AndreyPlis/balcon/render_eve_door.png

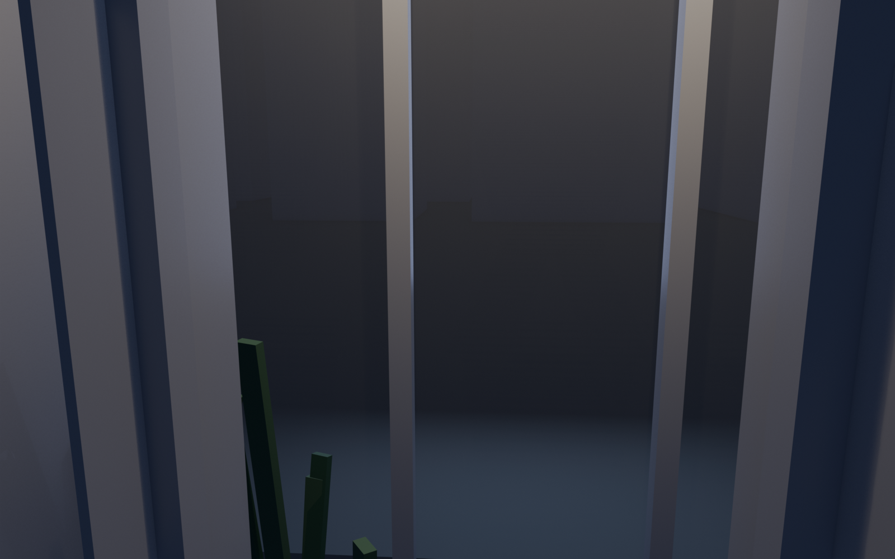
render_eve_door.png
