AndreyPlis/balcon/render_eve_corner.png

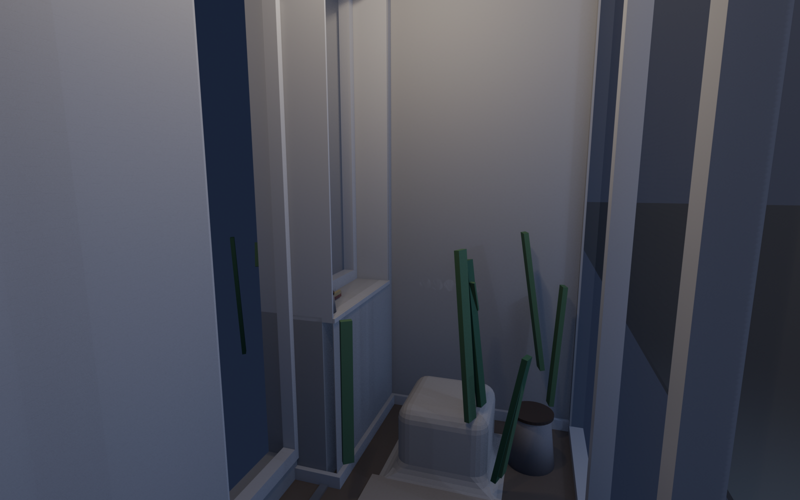
render_eve_corner.png
