AndreyPlis/balcon/guide.md

# Утепление лоджии PIR-панелями

Гайд собран из трёх роликов. Общий каркас — монтаж PIR. Финиш расходится: Технониколь ведёт штукатурку по стеклохолсту, омский мастер клеит ГКЛ на фольгу и присоединяет лоджию к комнате.

Источники:

- [ТН](https://www.youtube.com/watch?v=9BPyGYhEAY8) — заводская схема под штукатурку, 3:59
- [PIR](https://www.youtube.com/watch?v=_zJsMWyXZt4) — утепление присоединяемой лоджии, 10:50
- [ГКЛ](https://www.youtube.com/watch?v=zC0hL7GAGbw) — обшивка гипсокартоном поверх того же утепления, 14:20

## Какую схему брать

**Лоджия остаётся отдельной комнатой, финиш — штукатурка, плитка или камень.** Плиты со стеклохолстом. Холст клеится к стене и держит штукатурку, плиты заранее не грунтуют. [0:54](https://www.youtube.com/watch?v=9BPyGYhEAY8&t=54)

**Лоджию присоединяют к комнате, финиш — ГКЛ и декоративный кирпич.** Фольгированный PIR, листы на клей-пене, отверстия в утеплителе не сверлят. [0:00](https://www.youtube.com/watch?v=zC0hL7GAGbw&t=0)

Отдельная лоджия прощает ошибки: в мороз её можно закрыть. При присоединении контур должен быть герметичным целиком. [0:22](https://www.youtube.com/watch?v=_zJsMWyXZt4&t=22)

## Порядок работ

**1. Окна до утепления.** Рамы застройщика меняют целиком: профиль плохо держит тепло и вес тройного пакета. В заказ закладывают зазор под плиты. Окна не до пола — снизу запас под утеплитель не нужен. Пенят в самое тёплое окно по прогнозу. [0:48](https://www.youtube.com/watch?v=_zJsMWyXZt4&t=48) [1:12](https://www.youtube.com/watch?v=_zJsMWyXZt4&t=72) [1:38](https://www.youtube.com/watch?v=_zJsMWyXZt4&t=98)

**2. Толщина от отметки пола.** Перекрытие лоджии ниже пола квартиры примерно на 8 см и неровно. 50 мм PIR плюс стяжка в верхних точках не помещаются. Варианты: 50 мм и ступенька около 20 мм, либо 30 мм и пол в одну плоскость с комнатой. 30 мм тепло держат, тёплым пол становится только от тёплого пола. [2:16](https://www.youtube.com/watch?v=_zJsMWyXZt4&t=136) [4:24](https://www.youtube.com/watch?v=_zJsMWyXZt4&t=264) [4:41](https://www.youtube.com/watch?v=_zJsMWyXZt4&t=281)

Ориентир по эквиваленту: 50 мм PIR примерно как 65 мм ЭППС. На стены в маленькой лоджии берут 50 мм. Над плитами потолка оставляют место под профиль натяжного потолка. [1:51](https://www.youtube.com/watch?v=_zJsMWyXZt4&t=111) [2:04](https://www.youtube.com/watch?v=_zJsMWyXZt4&t=124) [3:43](https://www.youtube.com/watch?v=_zJsMWyXZt4&t=223)

**3. Демонтаж.** Сначала закрывают продуваемые щели. На время запенивания окно на проветривании, вытяжку квартиры закрывают, иначе пену выдувает. Перемычку разбирают по кускам. Если за облицовкой минвата вентфасада — респиратор и закрытая кожа. [5:42](https://www.youtube.com/watch?v=_zJsMWyXZt4&t=342) [5:58](https://www.youtube.com/watch?v=_zJsMWyXZt4&t=358) [6:17](https://www.youtube.com/watch?v=_zJsMWyXZt4&t=377) [1:24](https://www.youtube.com/watch?v=_zJsMWyXZt4&t=84)

**4. Основание.** Перепад стен и пола не больше 1 см на 2 м, иначе штукатурка. Наплывы бетона сбивают перфоратором, остальное снимают диском по бетону. [0:21](https://www.youtube.com/watch?v=9BPyGYhEAY8&t=21) [2:40](https://www.youtube.com/watch?v=_zJsMWyXZt4&t=160)

**5. Плиты: потолок, стены, пол.** Ряды от окна, вразбежку, обрезок переносят на следующий ряд. Зазоры минимальные: плита влаги не боится, пена боится, щель становится мостиком холода. [1:07](https://www.youtube.com/watch?v=9BPyGYhEAY8&t=67) [8:02](https://www.youtube.com/watch?v=_zJsMWyXZt4&t=482) [8:28](https://www.youtube.com/watch?v=_zJsMWyXZt4&t=508)

Клей-пена LOGICPIR. Полоса разомкнутая, без замкнутого контура, иначе плиту раздует. Стыки пропенивают той же пеной. [1:28](https://www.youtube.com/watch?v=9BPyGYhEAY8&t=88)

Через 24 часа — фасадные дюбели, не меньше двух на плиту. На потолок дюбели ставят в любом случае. На фольгу завод пену единственным креплением не разрешает; на стенах пена у мастера оторвала скорее плиту, чем шов. [1:55](https://www.youtube.com/watch?v=9BPyGYhEAY8&t=115) [6:55](https://www.youtube.com/watch?v=_zJsMWyXZt4&t=415) [7:50](https://www.youtube.com/watch?v=_zJsMWyXZt4&t=470)

**6. Герметичный контур.** Каждый стык и каждая шляпка дюбеля — алюминиевый скотч, не самый тонкий. На полу скотч замыкает пароизоляцию. [3:10](https://www.youtube.com/watch?v=9BPyGYhEAY8&t=190) [9:43](https://www.youtube.com/watch?v=_zJsMWyXZt4&t=583)

**7. Пол.** Напольный LOGICPIR с алюмоламинатом идёт под сухую и мокрую стяжку: покрытие защищает фольгу от щёлочи. Стеновую плиту на пол кладут только если напольной нужной толщины нет, и тогда под стяжку стелят плёнку. В ролике напольная была только 50 мм, стеновая — 30 мм, на пол ушли стеновые. [3:10](https://www.youtube.com/watch?v=9BPyGYhEAY8&t=190) [3:15](https://www.youtube.com/watch?v=_zJsMWyXZt4&t=195) [8:41](https://www.youtube.com/watch?v=_zJsMWyXZt4&t=521)

Стяжка около 40 мм. Кладочная сетка в середине слоя. Наливной пол вместо грубого ровнителя, плюс фибра. Заливка в два приёма: первый слой с фиброй, через час второй без неё. Заводской вариант пола — полусухая стяжка. Через две недели работы трещин не было. [8:54](https://www.youtube.com/watch?v=_zJsMWyXZt4&t=534) [3:27](https://www.youtube.com/watch?v=9BPyGYhEAY8&t=207) [9:32](https://www.youtube.com/watch?v=_zJsMWyXZt4&t=572)

**8а. Финиш штукатуркой.** Базовый слой, в него щелочестойкая фасадная сетка, затирка. Финиш после высыхания, не раньше 72 часов: шпаклёвка, шлифовка, грунт, затем декоративная штукатурка, плитка или камень. [2:14](https://www.youtube.com/watch?v=9BPyGYhEAY8&t=134) [2:35](https://www.youtube.com/watch?v=9BPyGYhEAY8&t=155)

**8б. Финиш ГКЛ.** Влагостойкий лист 12 мм, можно в два слоя. Направляющий 27×28 клеят пеной к полу; в стяжку его сажают газовым пистолетом — это единственное жёсткое основание. Пока пена встаёт, на PIR клеят пятаки из ГКЛ или фанеры и в них вкручивают подвесы-упоры. Сквозь утеплитель не сверлят. Профили оставляют там, где за листом розетки и провода. Остальные листы клеят клей-пеной к полу и к плитам. [0:27](https://www.youtube.com/watch?v=zC0hL7GAGbw&t=27) [1:10](https://www.youtube.com/watch?v=zC0hL7GAGbw&t=70) [2:41](https://www.youtube.com/watch?v=zC0hL7GAGbw&t=161) [12:19](https://www.youtube.com/watch?v=zC0hL7GAGbw&t=739)

Откосы грунтуют и сажают на Perlfix либо на цементную штукатурку по всей площади, с контактным слоем на стене и на листе, в уровень и под 90°. Высохший откос — ребро, в которое упирается стена. Под декоративный кирпич откос из ГКЛ подходит. Под обои откос делают пластиковым: окно плачет, обои отходят. [4:26](https://www.youtube.com/watch?v=zC0hL7GAGbw&t=266) [6:12](https://www.youtube.com/watch?v=zC0hL7GAGbw&t=372) [7:17](https://www.youtube.com/watch?v=zC0hL7GAGbw&t=437)

Где профилю нет места, лист фрезеруют и клеят целиком на клей-пену. В пене у рамы — паз 12 мм на глубину около 1 см. Металл запенивают умеренно. Подоконник потом добавляет точку крепления. Под кирпич сплошь не шпаклюют: перфоуголок на стыке с обоями, Волма Шов. [9:59](https://www.youtube.com/watch?v=zC0hL7GAGbw&t=599) [10:12](https://www.youtube.com/watch?v=zC0hL7GAGbw&t=612) [11:51](https://www.youtube.com/watch?v=zC0hL7GAGbw&t=711) [12:46](https://www.youtube.com/watch?v=zC0hL7GAGbw&t=766)

## Лайфхаки

| Приём | Зачем | Где |
|---|---|---|
| Пена разомкнутым контуром | Замкнутая полоса запирает воздух, плиту выгибает | [1:28](https://www.youtube.com/watch?v=9BPyGYhEAY8&t=88) |
| Монтаж от окна | Самый холодный стык получается самым плотным | [8:28](https://www.youtube.com/watch?v=_zJsMWyXZt4&t=508) |
| Скотч на шляпки дюбелей | Отверстие крепежа — такая же дыра, как стык | [9:43](https://www.youtube.com/watch?v=_zJsMWyXZt4&t=583) |
| Толстый алюминиевый скотч | Тонкий рвётся на фольге и на шляпках | [9:43](https://www.youtube.com/watch?v=_zJsMWyXZt4&t=583) |
| Два пистолета | Клей-пену не увлажняют, монтажную увлажняют; смешивать их в одном пистолете нельзя | [10:48](https://www.youtube.com/watch?v=zC0hL7GAGbw&t=648) |
| Tytan 60 секунд | Остальные клей-пены схватываются сильно дольше, лист успевает сползти | [12:34](https://www.youtube.com/watch?v=zC0hL7GAGbw&t=754) |
| Пятак из ГКЛ под подвес | Упор на время пены без дыры в PIR | [1:10](https://www.youtube.com/watch?v=zC0hL7GAGbw&t=70) |
| Палец на фольге под лазер | Зелёный луч на фольге не виден | [3:18](https://www.youtube.com/watch?v=zC0hL7GAGbw&t=198) |
| Глубина фрезы по лезвию ножа | Лезвие между двумя обрезками равно толщине картона, картон остаётся | [8:39](https://www.youtube.com/watch?v=zC0hL7GAGbw&t=519) |
| Отступ 55 мм от края площадки фрезера | Иначе паз уезжает от линии сгиба; свой фрезер надо перемерить | [8:00](https://www.youtube.com/watch?v=zC0hL7GAGbw&t=480) |
| Профиль пилят, а не режут ножницами | Ножницы заминают полки, профиль потом не встаёт | [3:58](https://www.youtube.com/watch?v=zC0hL7GAGbw&t=238) |
| Провода держит пена | Алюминиевый скотч нагрузку не несёт | [6:54](https://www.youtube.com/watch?v=zC0hL7GAGbw&t=414) |
| Сетку поднимают в тело стяжки | Сетка на PIR не армирует слой | [8:54](https://www.youtube.com/watch?v=_zJsMWyXZt4&t=534) |
| Болгарка по бетону греется | Наплывы сначала перфоратором, диск только на остаток | [2:40](https://www.youtube.com/watch?v=_zJsMWyXZt4&t=160) |
| Смету углов считают по штукам | Площади мало, углов много, цена за м² обманывает | [13:13](https://www.youtube.com/watch?v=zC0hL7GAGbw&t=793) |

Паузы, которые нельзя сжимать: сутки до дюбелей, трое суток до декоративной штукатурки, около часа между слоями наливного пола.
