AndreyPlis/balcon/docs/superpowers/specs/2026-10-06-loggia-blender-design.md

# Loggia → Blender: визуализация чистового интерьера

Дата: 2026-10-06. Источник геометрии: `Loggia.FCStd` (открыт и проверен через FreeCAD MCP), размеры — `loggia_params.md`, отделка — `пол.md` / `потолок.md` / `стены.md`.

## Цель

Сцена `.blend` с чистовым интерьером лоджии после ремонта + рендеры EEVEE (день и вечер, 2 ракурса). Скрытые конструктивные слои (PIR, рейки, гофра, подвесы) не показываются.

## Подход

Экспорт видимой отделочной геометрии из FreeCAD в OBJ → импорт в Blender (мм → м, масштаб 0.001) → материалы, декор, свет, камеры. Основание: вся отделка уже смоделирована в FCStd 1:1 — импорт исключает ошибки ручной перестройки.

## Состав сцены

Из FCStd (видимые слои):
- Коробка: задняя стена с проёмами, боковые стены, плиты пола/потолка, панорамное остекление (рама 70 мм, стеклопакет, доборы 120/110).
- Входной блок: окно (стекло), дверь (полотно), откосы Venta, ступень с SPC, порожек Лука 37 мм.
- Отделка: пол SPC «Дуб Берн» (Z 129–133), стены и задняя стена — панели «Кирпич серый», потолок — 27 ламелей ПВХ по 100 мм + доборная (Z 2695–2705), GX53 — 2 светильника по макету (в смете 3; расхождение зафиксировано, следует макету), подоконник ПВХ 200 мм, плинтусы ПВХ, рамка Legrand Valena 5 постов (простенок справа от двери, Z≈900).

Материалы (процедурные, без внешних ассетов):
- Пол: тёплый коричневый дуб, доски с расшивкой (Wave+Noise).
- Стены: серый кирпич (Brick Texture, серые тона, шов светлее).
- Потолок/ПВХ/рама/откосы/подоконник/дверь: белый пластик (лёгкий шершавый глянец).
- Стекло: прозрачное (Glass BSDF / EEVEE-эквивалент с блендом), лёгкий зелёный оттенок кромки не нужен.

Декор (лёгкий, на полу/подоконнике, не по спецификации):
- Коврик у панорамы, пуф-подушка, сансевиерия в кашпо на полу (угол у панорамы), маленькое растение на подоконнике, 2–3 книги.

Свет и камеры:
- День: Sun с улицы через панораму + небо, Evening-вариант отключён.
- Вечер: тёмное окружение, GX53 — эмиссивные диски 4000K + небольшие Point-источники для засвета.
- Камеры: «из двери» (как точка замеров) и «из угла» на панораму/подоконник.
- Рендер: EEVEE, 4 картинки (2 ракурса × день/вечер).

## Результат

- `loggia_design.blend` в корне репо (экспорт OBJ рядом, `loggia_export/`).
- 4 PNG-рендера: `render_day_door.png`, `render_day_corner.png`, `render_eve_door.png`, `render_eve_corner.png`.

## Не входит

Мебельные модули/шкафы, вид с улицы, разнесённый вид пирога, анимация, Cycles.
