AndreyPlis/balcon/loggia_params.md

# Параметрика модели «Loggia» — все размеры в мм

СК: origin = левый задний угол на уровне пола лоджии; X — слева направо, Y — от входа (задняя стенка) к панораме, Z — вверх.
Точка обзора замеров: человек стоит в двери, смотрит на панораму.

## 1. Помещение — внутренние габариты

| Параметр | Замер | В модели |
|---|---|---|
| Длина X (между боковыми стенами) | пол 2793/2789, потолок 2784/2788 | **2791** |
| Глубина Y (задняя стена → остекление) | лев. 1075 низ / 1065 верх, прав. 1081/1072 | **1077** |
| Высота Z | 2798–2811, среднее по 7 точкам | **2806** |
| Наклон стен (в модели — прямота, в допуск) | бока ~10, торцы ~5 | — |
| Объём / площадь пола | — | 8.43 м³ / 3.01 м² |

## 2. Задняя стенка — входной блок

| Элемент | Замер | В модели |
|---|---|---|
| Простенок слева (до окна) | 125 | X 0–125 |
| Окно ширина | 734 (1437.5 − 703) | X 125–859 |
| Окно высота / низ от пола | 1570 / 915–920 | Z 917–2488 (верх общий с дверью, `BlockTop`) |
| Дверь ширина | 703 | X 859–1562 |
| Дверь: порог / полотно | +230 / +280 (перемер), проём 2258 | Z 230–2488 |
| Простенок справа | 1209 / 1213 / 1215 (перемер) | **1229 расчёт** (+14 непараллельность боковых стен) |
| Над проёмом до потолка | 307 / 320 (перемер, потолок у двери 2807) | 318 |
| Откос двери правый | 140 | Y 0–140 за грань |
| Рамы блока (утоплены) | — | Y −140…−190 |

## 3. Панорамное остекление (фронт)

| Параметр | Замер | В модели |
|---|---|---|
| Низ рамы от пола | 180 | Z 180 |
| Верх рамы от потолка | 120 | Z 2686 |
| Высота стекла | 2506 (расчёт) | 180 + 2506 + 120 = 2806 ✓ |
| Боковые стены | длина 1065–1081 | заканчиваются на Y 1077 (`Dep`), внутрь зоны панорамы не заходят |
| Плоскость рамы панорамы | — | Y 1077 (`GlazY = Dep`), в плоскости торцов стен |
| Добор левый (до штапика) | 120 (перемер; ранее 125–140) | панель в плоскости остекления, ширина по X 120, толщина 10, на всю высоту |
| Добор правый | 110 (перемер; ранее 125) | ширина по X 110, толщина 10, на всю высоту |
| Рама панорамы | — | X 120–2681 (между доборами), профиль 70 условный, Y 1077–1147 |
| Стеклопакет (факт, установлен) | двухкамерный 4‑14‑4‑14‑4i, толщина 40, одно i‑стекло | U центра ~1.3, по окну ~1.4 Вт/м²·К; потери при −25 °C ≈ 440 Вт, общие потери лоджии ≈ 11 Вт/К |
| Площадь остекления | — | 2561 × 2506 = 6.42 м² |

## 4. Элементы внутри лоджии

| Элемент | Размеры | Позиция |
|---|---|---|
| Подоконник | 735 × 135 × 20 | в проёме окна, Y −135…0 (перемер глубины 135; до рамы на 140 остаётся 5), верх Z 917–920 |
| Ступень | 703 × 150 × 230 | в откосе двери, Y −150…0, заподлицо со стеной (перемер), полотно двери на +280 |

## 5. Конструктив и материалы

| Элемент | Материал | Примыкание / примечание | В модели |
|---|---|---|---|
| Левая боковая стена | Кирпич | К тёплому помещению | `WallLeft_Brick`, толщина 120 (!! заглушка) |
| Правая боковая стена | Кирпич | К тёплому помещению | `WallRight_Brick`, толщина 120 (!! заглушка) |
| Внутренняя (задняя) стена | Кирпич | Стена дома, тёплая | `WallBack`, толщина 300 (!! заглушка) |
| Пол | Ж/б плита | — | `SlabFloor`, 150 (!! заглушка) |
| Потолок | Ж/б плита | — | `SlabCeil`, 160 (!! заглушка) |
| Панорама, профиль | Melke Evolution 70 (ПВХ) | Монтажная глубина 70 = `FrameT` | `FrontParapet`, `FrontTopBand` |
| Панорама, стеклопакет | 4/14/4/14/4i | Двухкамерный 40 мм, одно i‑стекло | `Glazing` |
| Окно входного блока | 4/14/4/14/4i | То же заполнение | `BackWindowGlass` |
| Доборы панорамы | ПВХ | — | `RevealPan_Left/Right` |
| Подоконник, дверь, ступень | ПВХ / ПВХ / кирпич‑бетон | — | `Sill`, `BackDoorLeaf`, `Step` |

Материал записан на каждом теле в FreeCAD в строковых свойствах `Material` и `Note` (группа «Loggia»), а также в таблице `Params`, блок «МАТЕРИАЛЫ» (строки 36–44).
Толщины стен и плит не замерялись.

## 6. Утепление и отделка

В модели есть (восстановлено после чистки):

- **Утепление**: `InsLeft`/`InsRight` — PIR 50 (боковые); `InsBack_PierL`/`InsBack_PierR`/`InsBack_Top`/`InsBack_UnderWin` — PIR 30 (задняя); `InsCeil` — PIR 50; `InsFloor` + `InsFloor2` — пол, 2 слоя по 50. Материал и назначение каждого тела — в свойствах `Material`/`Note` (группа «Loggia»).
- **Потолок**: 3 профиля CD 60×27 (`CeilProf1..3`), 12 подвесов (`CeilHang01..12`), 8 панелей ПВХ Venta 375×3000×8 глянец белая (`CeilPanel01..08`, полосы 1077, последняя — подрезка 166), GX53 (`Lamp1/2_*`, `Lamp3_*`).
- **Стены**: каркас — **брусок строганый 30×40 (Лемана ПРО, хвоя Оптима) на пене к фольге, шаг 400, все стены** (`LatL_*`, `LatR_*`, `LatB_*`, включая вертикальные вставки над проёмом и под окном — продолжение сетки; полость 30 — под гофру D20; брусок с антисептиком-огнебиозащитой); `Material`/`Note` прописаны. Панели МДФ Stella «ледяное дерево» 2700×200×6 горизонтально (`FinB_*`, `FinL`, `FinR`), плинтус (`Base*`), подоконник 200 мм (`SillNew`), накладные механизмы, корпуса вертикально на рейках: тройной блок Legrand Quteo с/з — левая стена, на `LatL_2` (ось Y=600, Z≈780–1020, `SocketBox3`); выключатель (Z=900) + Grand Meyer MST-1 (Z=1000) — задняя стена справа от входа, на `LatB_R1` (ось X=1800, `SocketBox1/2`), без подрозетников и закладных. Пирог стен: левая/правая 86 мм, задняя 66 мм ([проект.md](проект.md)); в `Params` — `LatT` 30 / `LatW` 40 (61–62), `LatLT` 30 / `LatLW` 40 (72–73), `FinT` 6.
- **Пол**: PIR слой 2, ГВЛВ 20 (`FloorGVL`), подложка 3 (`FloorSub`), SPC Corsa Deco 5,3 (`FloorSPC`, `StepSPC`), ступень после среза (`Cut_StepUnder`, `WallBackStep`, `Threshold`, `BaseJamb*`).
- **Электрика**: ввод (`CableEntry*`), провода (`Wire*`), распаячная коробка (`JBox`), датчик пола (`WireSens*`).

Таблица `Params` содержит блоки «МАТЕРИАЛЫ» (36–44), «ВВОД КАБЕЛЯ» (45–48), «УТЕПЛЕНИЕ» (49–71: PirT 50 / PirWT 30, каркас потолка CD, ламели, каркас стен LatT/LatW, финиш 3 мм, пирог пола).

## Контрольные цепочки

- Вертикаль окна: 917 + 1571 + 318 = 2806 ✓
- Вертикаль двери: 230 + 2258 + 318 = 2806 ✓ (замер у двери 230 + 2258 + 320 = 2808 ≈ 2807)
- Панорама: 180 + 2506 + 120 = 2806 ✓
- Горизонталь задней стенки: 125 + 734 + 703 + 1229 = 2791 ✓ (замер на высоте 1 м: 125 + 1440 + 1215 = 2780, наклон стен)
- От левой стены до правого края окна: 125 + 734 = 859 ≈ 863 (замер) ✓
