AndreyPlis/balcon/план работ.md

# План работ — утепление и отделка лоджии

Сквозной порядок работ по проекту ([проект.md](проект.md)). Конструкции, смета и альтернативы — в разделах проекта.

## Раскладка по дням (1 человек; порядок «подготовка → утепление → черновая → финиш», паузы из [гайда](guide.md) не сжимать)

**День 0 — подготовительный: подготовка пола, грубый срез ступени, ввод электрики (все грязные работы)**
Подготовка пола и потолка: сбить наплывы >10 мм перфоратором (диск по бетону — только на остаток), пропылесосить → грубый срез ступени: борозда алмазным диском по периметру + отбойник (пика/лопатка), основная масса до ~117 мм → торец среза в комнату зачистить → завод электрики: бур 25×600, сквозное отверстие Ø25, ось **80 мм от левой стены, у верха окна (Z=2488)** — простенок, вне пирога левой стены (PIR 50 + полость 40 + панель 3) и с запасом под подрозетник Ø68 в комнате (Ø68 на оси 80 → 46–114 от угла), **ввод один 3×2,5 с PE в гофре D20 сквозь стену** (шлейф от розетки в комнате; гофра до распаячной коробки — кабель заменяем), фольгу вокруг ввода — скотч, зазор вокруг гофры временно — ветошью (пена — при отделке откосов).
*Материалы на день:*

| Материал | Кол-во | Цена, ₽ | Ссылка |
|---|---|---|---|
| Кабель ВВГ-Пнг(А) 3×2,5 ГОСТ (ввод — единственный кабель в отверстии) — **куплен** | ~10 м | 123/м | [electrolait.ru](https://electrolait.ru/shop/kabel/vvg/vvg-pnga-3h25-dmitrov-kabel-gost/) |
| Гофра ПВХ D20, самозатухающая (ввод сквозь стену + трасса до коробки; остаток бухты — трассы розеток и тёплого пола в Д4; при заказе уточнить зонд) — **куплена** | 12 м | 13/м | [electrolait.ru](https://electrolait.ru/shop/prokladka-kabelya/gofra/truba-pvh-gofrirovannaya-diametr-20mm/) |
| Изолента, малярный скотч (расходники) | — | — | — |

*Инструмент* (прочерк — уже есть в хозяйстве):

| Инструмент | Цена, ₽ | Ссылка |
|---|---|---|
| Перфоратор SDS-plus | — | — |
| Бур SDS-plus Rage 562560 25×600 мм (4,5/5, 105 отзывов; Ø25 = наружный Ø гофры D20 +25%; Ø20 гофре мало — не пройдёт; сверлить с перерывами, беречь напайку от арматуры) — **куплен** | — | [lemanapro.ru](https://lemanapro.ru/product/bur-po-betonu-sds-plus-rage-562560-25x600-mm-89369128/) |
| УШМ 125 мм | — | — |
| Диск алмазный по бетону Rage 600132 сегментный 125×2,2 — **куплен 07.10** | — | [lemanapro.ru](https://lemanapro.ru/product/disk-almaznyy-po-betonu-rage-600132-segmentnyy-125x222x22-mm-89435058/) |
| Пика по бетону SDS-plus 250 мм — **куплена** | — | [lemanapro.ru](https://lemanapro.ru/product/pika-po-betonu-sds-plus-250-mm-86407420/) |
| Зубило лопаточное SDS-plus 40×250 мм — **куплено** | — | [lemanapro.ru](https://lemanapro.ru/product/zubilo-lopatochnoe-sds-plus-40x250-mm-86508679/) |
| Чашка алмазная двухрядная по бетону Vira 592035 125×22,2 мм (19 отзывов; к УШМ — шлифовка плиты пола, ровный след без биения) — **куплена 13.10** | — | [lemanapro.ru](https://tver.lemanapro.ru/product/chashka-almaznaya-dvuhryadnaya-po-betonu-vira-592035-125x222-mm-89418165/) |
| Пылесос, очки, респиратор, перчатки | — | — |

**Итого покупок дня 0: 4 073 ₽** — всё куплено (материалы 1 386 + инструмент 2 687; диск Rage 876 ₽ — 07.10, чаша Vira 558 ₽ — 13.10).

**День 1 — утепление потолка и стен**
Распил: 3 CD по ~2618 (УШМ); брусок 30×40 — 12 шт до ~2806 (торцовка/ножовка; под антисептиком-огнебиозащитой с Д0) → PIR потолка на клей-пену (листы 1190×590 двумя продольными рядами 590+487 вдоль 2791, **вразбежку**: ряд 590 [1190+1190+411], ряд 487 [411+1190+1190] — вставка ряда из отрезка предыдущего листа, швы соседних рядов разнесены на ≥411; отрезки 103 мм — в доборы; ~5 листов, полосы разомкнутые, от угла панорамы) → PIR стен (**вразбежку**: боковые — колонки 590/487, колонка 590 [1190+1190+426] от панорамы, колонка 487 [426+1190+1190] — вставки из листов-доноров, ~9–10 листов; задняя 30-мм — колонки с тем же чередованием [1190+1190+426]/[426+1190+1190] с подрезкой проёмов; от угла панорамы, стыки пропенить). Пол (Д2/Д3) — та же раскладка **вразбежку в двух уровнях**: слой 1 — ряд 590 [1190+1190+411], ряд 487 [411+1190+1190]; слой 2 — зеркально (ряд 590 [411+1190+1190], ряд 487 [1190+1190+411]) — сдвиг швов и внутри слоя, и между слоями ≥411 ≥200. Итого 50-мм: ~22,5 чистых листа из 25 (5 уп) — запас ~2,5 листа.
*Материалы на день:*

| Материал | Кол-во | Цена, ₽ | Ссылка |
|---|---|---|---|
| PIR Logicpir Баня ф/ф Г1 L-кромка 1190×590×50, уп. 5 плит/3,51 м² — фирменный магазин ТН (Г1 — не «Балкон»/«Полы» с Г4; обе позиции заказа с L-кромкой; потолок + стены ≈ 3 уп, общий заказ 5 уп) | 3 уп | 4 329/уп | [tver.tstn.ru](https://tver.tstn.ru/product/logicpir-banya-f-f-g2-l-1190kh590kh50/) |
| PIR Logicpir Баня ф/ф Г1 L-кромка 1190×590×30, уп. 8 плит/5,62 м² — фирменный магазин ТН (единый формат с 50-мм) | 1 уп | 4 918/уп | [tver.tstn.ru](https://tver.tstn.ru/product/logicpir-banya-f-f-g2-l-1190kh590kh30/) |
| Клей-пена Logicpir 1000 мл (потолок + стены) — фирменный магазин ТН (−484 ₽/баллон к Лемане) | 4 шт | 1 414 | [tver.tstn.ru](https://tver.tstn.ru/product/kley-pena-tekhnonikol-logicpir-1000-ml/) |

*Инструмент* (прочерк — уже есть в хозяйстве):

| Инструмент | Цена, ₽ | Ссылка |
|---|---|---|
| УШМ 125 мм (уже есть) + диск отрезной 125×22,2×1,2, 3 шт — **куплены 13.10** | — | [lemanapro.ru](https://lemanapro.ru/product/disk-otreznoy-po-metallu-sibrteh-743147-125x222x12-mm-88022834/) |
| Пистолет для пены №1 (клей-пена) Вихрь 73/3/6/6 — **куплен 13.10** | — | [lemanapro.ru](https://lemanapro.ru/product/pistolet-dlya-montazhnoy-peny-vihr-73-3-6-6-85088621/) |
| Уровень лазерный Ermenrich LT20 | 1 890 | [lemanapro.ru](https://lemanapro.ru/product/uroven-lazernyy-ermenrich-lt20-84635-92088726/) |
| Уровень магнитный усиленный Зубр «Профессионал-М» 1000 мм с зеркальным глазком (ВсеИнструменты) | 2 257 | [vseinstrumenti.ru](https://www.vseinstrumenti.ru/product/magnitnyj-usilennyj-uroven-zubr-professional-m-1000-mm-s-zerkalnym-glazkom-34589-100-z01-1717052/) |
| Правило алюминиевое трапеция с рёбрами жёсткости СИБРТЕХ 89602, 1,5 м (ВсеИнструменты; 114 отзывов; короче Hesler 2,5 — заднюю стену 2619 выводить в два приёма, продольный рез МДФ — по бруску 30×40 как направляющей) | 929 | [vseinstrumenti.ru](https://www.vseinstrumenti.ru/product/alyuminievoe-trapetsievidnoe-pravilo-s-rebrami-zhestkosti-1-5-m-sibrteh-89602-543315/) |
| Нож строительный + запасные лезвия | — | — |
| Рулетка, угольник, пылесос, стремянка | — | — |
| Очки, респиратор, перчатки | — | — |

**Итого покупок дня 1: 29 394 ₽** (материалы 23 561 + инструмент 5 833 — из них куплены 13.10 диски 81 ₽ и пистолет №1 676 ₽; осталось докупить на 5 076 ₽: лазер LT20 1 890 — Лемана, уровень Зубр 2 257 + правило СИБРТЕХ 1,5 м 929 — ВсеИнструменты; утеплитель и клей-пена — фирменный магазин ТН/tstn).

⏳ сутки до дюбелей всего контура.

**День 2 — дюбели контура + пол слой 1 (замыкание теплоизоляции)**
12 термодюбелей Sormat сквозь прямые подвесы на потолке (тарелка прижимает подвес) → дюбели стен: 18 остатков Sormat + тарельчатые 10×90 (2/плита) → весь алюминиевый скотч одним заходом: швы, шляпки, периметр потолок↔стены → вечером PIR пола слой 1: полосы пены разной толщины по лазеру.
*Материалы на день:*

| Материал | Кол-во | Цена, ₽ | Ссылка |
|---|---|---|---|
| Подвес прямой Knauf 60×27, 30×302 мм, 0,9 мм (Петрович; оригинал, длиннее и жёстче 120-го — торчащие концы ножек отогнуть вверх или откусить) | 12 шт | 18/шт | [tver.petrovich.ru](https://tver.petrovich.ru/product/106238/) |
| Термодюбель Sormat 8×155 (12 потолок + 18 стены) | 1 уп. | 658 | [lemanapro.ru](https://lemanapro.ru/product/dyubel-dlya-teploizolyacii-sormat-gvozd-s-termogolovkoy-8x155-mm-30-sht-89397658/) |
| Дюбель теплоизоляции 10×90 (стены) | 1 уп. | 177 | [lemanapro.ru](https://lemanapro.ru/product/dyubel-dlya-teploizolyacii-10x90-mm-30-sht-84039098/) |
| Скотч алюминиевый Unibob 50 мм×40 м (потолок + стены; остаток — на пол в Д3; ВсеИнструменты, 104 отзыва) | 2 шт | 740 | [vseinstrumenti.ru](https://www.vseinstrumenti.ru/product/alyuminievaya-klejkaya-lenta-unibob-50-mm-h-40-m-134860-1103742/) |
| PIR Logicpir Баня ф/ф Г1 1190×590×50 (пол, слой 1 — из общего заказа 5 уп) | 1 уп | 4 329/уп | [tver.tstn.ru](https://tver.tstn.ru/product/logicpir-banya-f-f-g2-l-1190kh590kh50/) |
| Клей-пена Logicpir 1000 мл (tstn) | 1 шт | 1 414 | [tver.tstn.ru](https://tver.tstn.ru/product/kley-pena-tekhnonikol-logicpir-1000-ml/) |

*Инструмент:*

| Инструмент | Цена, ₽ | Ссылка |
|---|---|---|
| Перфоратор SDS-plus | — | — |
| Бур по бетону Rage Quadro-X 566821 8×210 мм, 2 шт. — **куплены 13.10** | — | [lemanapro.ru](https://lemanapro.ru/product/bur-po-betonu-sds-plus-rage-quadro-x-566821-8x210-mm-89383430/) |
| Бур по бетону SDS-plus 10×160 мм, 2 шт. — **куплены 13.10** | — | [lemanapro.ru](https://lemanapro.ru/product/bur-po-betonu-sds-plus-10x160-mm-89383380/) |
| Пистолет №1, лазер (куплены в Д1) | — | — |
| Нож, пылесос, стремянка, очки, респиратор | — | — |

**Итого покупок дня 2: 9 036 ₽** (материалы 8 274 + инструмент 762 — буры куплены 13.10; подвес — Петрович 216, PIR пола и пена — tstn, скотч — ВсеИнструменты).

⏳ сутки до слоя 2.

**День 3 — черновая: пол слой 2 + ГВЛВ, каркас стен**
Пол слой 2 вразбежку ≥200 мм → швы и периметр скотчем — **пароизоляционный контур замкнут целиком** → ГВЛВ Суперпол на пену, фальш, зазор 3 мм, пригруз → параллельно каркас стен на клей-пену к фольге: **брусок строганый 30×40 (Лемана), пропитанный антисептиком-огнебиозащитой накануне (сутки сушки)**, полка 40 к PIR, все стойки вертикальные, шаг ≤400, над проёмом и под окном — вертикальные вставки (продолжение сетки), прижимать правилом + малярный скотч.
*Материалы на день:*

| Материал | Кол-во | Цена, ₽ | Ссылка |
|---|---|---|---|
| PIR Logicpir Баня ф/ф Г1 1190×590×50 (пол, слой 2 — из общего заказа 5 уп) | 1 уп | 4 329/уп | [tver.tstn.ru](https://tver.tstn.ru/product/logicpir-banya-f-f-g2-l-1190kh590kh50/) |
| ГВЛВ Knauf Суперпол 600×1200×20 | 6 шт | 550/шт | [lemanapro.ru](https://lemanapro.ru/product/gipsovoloknistyy-list-gvlv-pk-20-mm-knauf-superpol-600x1200-mm-12703221/) |
| Клей-пена Logicpir 1000 мл (tstn) | 1 шт | 1 414 | [tver.tstn.ru](https://tver.tstn.ru/product/kley-pena-tekhnonikol-logicpir-1000-ml/) |
| Брусок строганый 30×40×3000, хвоя Оптима (антисептик — накануне) | 12 шт | 193/шт | [lemanapro.ru](https://lemanapro.ru/product/brusok-stroganyy-30x40x3000-mm-celnyy-hvoya-sort-optima-fgis-lk-81947392/) |
| Скотч алюминиевый (остаток), малярный скотч, пригруз (подручный) | — | — | — |

*Инструмент:*

| Инструмент | Цена, ₽ | Ссылка |
|---|---|---|
| Пистолет №1, лазер (куплены в Д1) | — | — |
| Уайт-спирит + тряпки (обезжиривание спинок ПН перед приклейкой) | — | — |
| Нож, пылесос (правило куплено в Д1) | — | — |

**Итого покупок дня 3: 11 359 ₽** (только материалы; PIR слоя 2 и пена — tstn).

⏳ сутки: ГВЛВ под пригрузом, ПН полимеризуется. Лоджия уже тёплая — контур работает.

**День 4 — электрика за каркасом + финиш потолка**
Трассы за панелями: вводной 3×2,5 — в гофре ПВХ D20 от розетки в комнате сквозь стену (проложена в Д0), по задней полости поверх PIR до распаячной коробки (подъём между брусками, далее по фольге); от коробки ветви: свет 3×1,5 к GX53 и выключателю на задней стене (гофра ПВХ D16), розетки 3×2,5 по левой стене поверх PIR со спуском к блоку и тёплый пол 3×2,5 к Grand Meyer MST-1 на задней стене — обе ветви в гофре ПВХ D20 из остатка бухты Д0 (3×2,5 в D16 не протягивается: плоский кабель 13×6 шире прохода 10,7 мм) → блоки накладные, корпуса вертикально на рейках: тройной блок Legrand Quteo с/з (782238) — левая стена, на рейке (ось Y=600, Z≈780–1020); выключатель (Z=900) + Grand Meyer MST-1 (Z=1000) — задняя стена справа от входа, вертикально на рейке (ось X=1800), крепёж сквозь панель в брусок; гофра датчика от Grand Meyer MST-1 вниз → потолок: отгиб ножек 23–25 мм по лазеру (луч на фольге не виден — палец/экран), 3 CD на клопы → панели ПВХ Venta 375×3000×8 на саморезах (8 полос по 1077, последняя — подрезка), вырезы Ø90 коронкой, светильники GX53, распаячная коробка (WAGO), кабель.
*Материалы на день:*

| Материал | Кол-во | Цена, ₽ | Ссылка |
|---|---|---|---|
| Гофра ПВХ D16, самозатухающая — свет 3×1,5 + датчик — **куплена** (D20 куплена в Д0) | — | — | — |
| Кабель ВВГ-Пнг(А) 3×1,5 ГОСТ (ветвь света от коробки: GX53 + клавиша) — **куплен** | — | — | — |
| Кабель ВВГ-Пнг(А) 3×2,5 ГОСТ (ветви розеток и тёплого пола от коробки) — **куплен** | — | — | — |
| Клемма WAGO на 3 провода | 6 шт | 66/шт | [electrolait.ru](https://electrolait.ru/shop/klemniki/wago-klemma-b-pasty-na-3-provoda/) |
| Коробка установочная СП 68×45 блочная | 5 шт | 19/шт | [electrolait.ru](https://electrolait.ru/shop/korobki/ustanovochnye/korobka-ustanovochnaya-sp-6865h45-blochnaya-sche-imt35100/) |
| Саморезы-клопы 3,5×9,5 (на вес) | ~60 шт | 32 | [lemanapro.ru](https://lemanapro.ru/product/samorezy-po-metallu-dilwis-ocinkovannye-ostrye-35x95-mm-na-ves-89384754/) |
| Профиль ПП/CD Knauf 60×27×3000 (распилен в Д1) — **в наличии 4 шт.** (3 в работу + запас) | 4 шт | — | — |
| Панель ПВХ Venta 375×3000×8 глянец белая (потолок: 8 полос × 1077, последняя — подрезка; Петрович — позиция из сметы проекта) | 5 шт | 575/шт | [petrovich.ru](https://petrovich.ru/product/1065311/) |
| Саморезы ЦКИ 4,2×25 с прессшайбой, 200 шт | 1 уп. | 505 | [lemanapro.ru](https://lemanapro.ru/product/samorezy-universalnye-cki-s-pressshayboy-ostrye-fosfatirovannye-42x25-mm-200-sht-92613264/) |
| Светильник Wolta Luce GX53 (Ø90) | 3 шт | 653/шт | [lemanapro.ru](https://lemanapro.ru/product/svetilnik-tochechnyy-vstraivaemyy-wolta-luce-wdl-gx53-06w-s-pod-otverstie-90-mm-gx53-cvet-belyy-92030646/) |
| Лампа GX53 10 Вт 4000К | 3 шт | 90/шт | [electrolait.ru](https://electrolait.ru/shop/lampy/svetodiodnye/gx53/lampa-svetodiodnaya-61-191-oll-gx53-12-230-4k-onlajt-61191/) |
| Коробка распределительная EKF 80×50×80 IP54 | 1 шт | 96 | [lemanapro.ru](https://lemanapro.ru/product/raspredelitelnaya-korobka-ekf-80x50x80-mm-ip54-cvet-chernyy-92974828/) |

*Инструмент:*

| Инструмент | Цена, ₽ | Ссылка |
|---|---|---|
| Шуруповёрт + бита PH2 | — | — |
| Дрель/шуруповёрт (коронка Ø89) | — | — |
| Набор коронок по дереву Matrix 64–127 мм | 561 | [lemanapro.ru](https://lemanapro.ru/product/nabor-koronok-po-derevu-matrix-704715-64-127-mm-87657902/) |
| Пассатижи + бокорезы (отгиб подвесов) | — | — |
| Кусачки/стриппер, индикаторная отвёртка, изолента | — | — |
| Лазер (куплен Д1), стремянка | — | — |

**Итого покупок дня 4: 8 919 ₽** (материалы 8 358 + инструмент 561; кабели ВВГ и гофра D16 куплены заранее — ~2 130 ₽ из материалов дня; Venta — Петрович).

**День 5 — финиш стен + пирог пола**
Панели МДФ Stella «ледяное дерево» 2700×200×6 горизонтально от угла, саморез в паз к бруску (каркас стоит двое суток; 15 рядов с подрезкой по высоте, куски без стыков) → подоконник ПВХ 200 от рамы → пирог пола: подложка EVA (канавка под датчик), датчик Rexant между греющими полосами, ИК-плёнка (торцы битумными изоляторами, PE-экран на PE), техплёнка 200 мкм.
*Материалы на день:*

| Материал | Кол-во | Цена, ₽ | Ссылка |
|---|---|---|---|
| Панель МДФ Stella «ледяное дерево» 2700×200×6 (стены + откосы) | 26 шт | 520/шт | [petrovich.ru](https://tver.petrovich.ru/product/1079995/) |
| Подоконник ПВХ 1000×200 белый | 1 шт | 433 | [lemanapro.ru](https://lemanapro.ru/product/podokonnik-pvh-1000x200-mm-cvet-belyy-89193400/) |
| Подложка Texfloor EVA с фольгой 3 мм, рулон 6,6 м² | 1 рул. | 2 145 | [lemanapro.ru](https://lemanapro.ru/product/podlozhka-texfloor-eva-3-mm-s-folgirovannym-sloem-66m2-rulon-93044098/) |
| ИК-плёнка Rexant 2,5 м² 550 Вт (с изоляторами) | 1 компл. | 5 279 | [lemanapro.ru](https://lemanapro.ru/product/infrakrasnaya-plenka-dlya-teplogo-pola-rexant-25-m-550-vt-90553937/) |
| Плёнка техническая армированная 200 мкм | 1 шт | 947 | [lemanapro.ru](https://lemanapro.ru/product/plenka-tehnicheskaya-armirovannaya-200-mkm-2x10-m-86272872/) |
| Саморезы ЦКИ 4,2×25 (вторая пачка — на стены) | 1 уп. | 505 | [lemanapro.ru](https://lemanapro.ru/product/samorezy-universalnye-cki-s-pressshayboy-ostrye-fosfatirovannye-42x25-mm-200-sht-92613264/) |
| Алюминиевый скотч (остаток) | — | — | — |
*Инструмент:*

| Инструмент | Цена, ₽ | Ссылка |
|---|---|---|
| Шуруповёрт + бита PH2 | — | — |
| Нож + запасные лезвия | — | — |
| Рулетка, угольник, лазер (куплен Д1) | — | — |

**Итого покупок дня 5: 15 084 ₽** (только материалы).

**День 6 — чистовой пол и ступень**
SPC плавающий от угла, зазор 8–10 мм → доводка среза ступени перфоратором: тонкий слой 117 → точная отметка ~107 мм по лазеру от готового ГВЛВ (чистый пол − 3 пены − 20 ГВЛВ − 3 подложки − 4 SPC) → на срез клей-пена + кусок ГВЛВ из подрезки + подложка EVA → SPC через ступень в замок до рамы блока (у рамы зазор 8–10, планки под подрезанные откосы). Торец среза (123×703) — зона квартиры, краска/уголок в любой день.
*Материалы на день:*

| Материал | Кол-во | Цена, ₽ | Ссылка |
|---|---|---|---|
| SPC Corsa Deco Laguna B300 1218×180×5,3, фаска, подложка IXPE, 2,631 м²/уп. | 2 уп. | 3 947/уп. | [petrovich.ru](https://petrovich.ru/product/1133918/) |
| Подложка EVA (остаток рулона) | — | — | — |

*Инструмент:*

| Инструмент | Цена, ₽ | Ссылка |
|---|---|---|
| Перфоратор SDS-plus (отбойник — доводка среза ступени; пика и лопатка куплены в Д1) | — | — |
| Лазер (куплен Д1), нож | — | — |
| Распорные клинья 8–10 мм (подручные) | — | — |
| Очки, респиратор, пылесос | — | — |

**Итого покупок дня 6: 4 886 ₽** (только материалы; диск/пика/лопатка — куплены в Д1).

**День 7 — финиш и пуск электрики**
Откосы двери и окна — полосы МДФ Stella 140×2700 (продольный раскрой) на монтажную пену (второй пистолет; металл рамы — умеренно), примыкание к раме — в упор с зазором 2–3 мм, шов пройти белым акриловым герметиком; углы стен и примыкания откосов — уголок МДФ Stella складной 24×24 в тон панелей (7 шт), на жидкие гвозди → плинтус по стенам (торцы к откосам 45°) + отрезок плинтуса вертикально у рамы поперёк проёма → подключение блока: WAGO, лампы GX53 → проверка света, розеток, экрана плёнки → уборка.
*Материалы на день:*

| Материал | Кол-во | Цена, ₽ | Ссылка |
|---|---|---|---|
| Герметик акриловый Soudal «Моментальный» белый 280 мл (швы откосов к раме) | 1 шт | 442 | [petrovich.ru](https://petrovich.ru/product/140610/) |
| Монтажная пена профессиональная 750 мл | 2 шт | при заказе | — |
| Плинтус напольный ПВХ 2200 мм | 3 шт | 168/шт | [lemanapro.ru](https://lemanapro.ru/product/plintus-napolnyy-pvh-cvet-belyy-220x23x58-mm-89348887/) |
| Выключатель Legrand Valena 1 кл. | 1 шт | 490 | [electrolait.ru](https://electrolait.ru/shop/ustanovka/legrand-ustanovka/valena/belii-valena/legrand-valena-vyklyuchatel-1kl-belyj/) |
| Терморегулятор Grand Meyer GM-119 | 1 шт | 2 780 | [electrolait.ru](https://electrolait.ru/shop/teplyj-pol/termoregulyatory/%d1%82%d0%b5%d1%80%d0%bc%d0%be%d1%80%d0%b5%d0%b3%d1%83%d0%bb%d1%8f%d1%82%d0%be%d1%80-grand-meyer-gm-119-6-%d1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) |
| Розетка Legrand Valena с заземлением | 3 шт | 440/шт | [electrolait.ru](https://electrolait.ru/shop/ustanovka/legrand-ustanovka/valena/belii-valena/legrand-valena-rozetka-s-zazemleniem-belaya/) |
| Рамка Legrand Valena 5 постов | 1 шт | 1 350 | [electrolait.ru](https://electrolait.ru/shop/ustanovka/legrand-ustanovka/valena/belii-valena/legrand-valena-ramka-5-ya-belaya/) |
| Клеммы WAGO (остаток) | — | — | — |

*Инструмент:*

| Инструмент | Цена, ₽ | Ссылка |
|---|---|---|
| Пистолет для пены №2 (монтажная) Вихрь 73/3/6/6 | 676 | [lemanapro.ru](https://lemanapro.ru/product/pistolet-dlya-montazhnoy-peny-vihr-73-3-6-6-85088621/) |
| Нож, стусло (подручное) | — | — |
| Шуруповёрт + бита PH2 | — | — |
| Индикаторная отвёртка, кусачки/стриппер, изолента | — | — |

**Итого покупок дня 7: 14 080 ₽** (материалы 13 404 + инструмент 676) + монтажная пена при заказе.

Контроль по смете: 4 073 + 876 (диск — куплен 07.10) + 29 394 + 9 036 + 11 359 + 8 919 + 15 084 + 4 886 + 14 080 = **97 707 ₽** = материалы 86 312 + инструменты 11 395 ✓ (PIR и клей-пена — фирменный магазин ТН в Твери, tver.tstn.ru: «Баня» Г1 L-кромка 50 мм ×5 уп 21 645 + 30 мм ×1 уп 4 918 + клей-пена LOGICPIR ×6 балл. × 1 414 = 8 484, итого 35 047 ₽; пена на 25% дешевле Леманы, PIR 600×1200 на Лемане Тверь закончился; правило СИБРТЕХ 1,5 м и скотч Unibob — ВсеИнструменты). Куплено заранее: инструменты — диск 876 (07.10), пика 161, зубило 188, бур 25×600 1 780, диски отрезные 81, пистолет №1 676, буры 8×210 — 534 и 10×160 — 228, чаша Vira 558 (остальное — 13.10; итого 5 082 ₽); материалы — кабели ВВГ 3×1,5 и 3×2,5, гофры ПВХ D16/D20, пылесос. Осталось докупить из инструмента: лазер LT20 1 890, уровень Зубр 2 257, правило СИБРТЕХ 929, коронки Matrix 561 (Д4), пистолет №2 676 (Д7) — итого 6 313 ₽.

**Дни 8–10 — пуск тёплого пола**
Уставка 27 °C, подъём ступенями +5 °C/сутки первые трое. Паузы из гайда, которые нельзя сжимать: сутки до дюбелей, сутки пригруза ГВЛВ, трое суток ступенчатого пуска.

## Технологические карты по фазам

**Фаза 1 — Подготовка и утепление контура (дни 0–2).**
День 0 (грязные работы): сбить наплывы >10 мм на плите пола и потолке (перфоратор, диск по бетону — только на остаток), пропылесосить; грубый срез ступени — борозда алмазным диском + отбойник (пика/лопатка) до ~117 мм; ввод электрики — сквозное отверстие Ø25 буром 25×600 через стену 400 мм, простенок слева от окна, ось 80 мм от левой стены, у верха окна (Z=2488 от пола лоджии; в комнате ≈2,23 м от пола), в комнате первой коронкой Ø68 ниша подрозетника на той же оси, бур — из ниши по уровню; ввод один 3×2,5 с PE в гофре D20 (шлейф от розетки в комнате; PE — под экран ИК-плёнки), фольгу у ввода — скотч, после прокладки зазор вокруг гофры запенить.
День 1–2: профиль CD напилить УШМ (3× 2618); брусок 30×40 — 12 шт подрезать до 2806 (торцовка/ножовка, заранее под антисептиком с Д0); перемерить термодюбели (нужно ≥155 мм при PIR 50). PIR потолка и стен на клей-пену (разомкнутые полосы, от угла панорамы, вразбежку, стыки пропенить) → сутки → дюбели всего контура: 12 Sormat 8×155 сквозь прямые подвесы на потолке (тарелка прижимает подвес) + 18 остатков Sormat и тарельчатые 10×90 на стенах (2/плита) → весь скотч одним заходом: швы, шляпки, периметр потолок↔стены → вечером PIR пола слой 1 на выравнивающие полосы пены по лазеру.

**Фаза 2 — Черновая отделка (дни 3–4).**
Пол слой 2 вразбежку (швы ≥200 мм) → швы и периметр алюминиевым скотчем — пароизоляционный контур замкнут целиком → ГВЛВ Суперпол на пену, фальц, зазор 3 мм, пригруз на сутки. Параллельно каркас стен на пену к фольге, шаг 400: брусок 30×45 (полость 30 под электрику, все стены), прижимать правилом до полимеризации (сутки).
Электрика за каркасом: 3×2,5 поверх PIR левой стены в гофре ПВХ D20, гофра датчика вниз (ПВХ D16); блоки накладные, корпуса вертикально на рейках: тройной блок Legrand Quteo с/з — левая стена (ось Y=600, Z≈780–1020); выключатель (Z=900) + Grand Meyer MST-1 (Z=1000) — задняя стена справа от входа (ось X=1800), крепёж в брусок. Потолок: отгиб ножек подвесов 23–25 мм по лазеру → 3 профиля CD на клопы (по 2 с каждой стороны) → панели ПВХ на саморезах в паз → вырезы Ø90 под GX53 коронкой → кабель 3×1,5 в гофре ПВХ D16 по фольге, распаячная коробка.

**Фаза 3 — Финишная отделка (дни 5–7).**
Панели МДФ Stella «ледяное дерево» горизонтально от угла, саморез в паз к бруску, без клея → подоконник ПВХ 200 мм от рамы (опора — откос и левый простенок).
Пирог пола: подложка EVA (канавка под датчик) → датчик Rexant в канавке между греющими полосами → ИК-плёнка (торцы битумными изоляторами, PE-экран на заземляющую жилу) → техплёнка 200 мкм → SPC плавающий от угла, зазор от стен 8–10 мм.
Ступень: грубый срез основной массы — в фазе 1 (подготовительный день, до ~117 мм); финишная доводка до ~107 мм от плиты лазером от готового ГВЛВ (чистый пол − 3 мм пены − 20 мм ГВЛВ − 3 мм подложки − 5,3 мм SPC) → на срез клей-пена + кусок ГВЛВ из подрезки + подложка EVA → плашки SPC в замок от пола через ступень до рамы блока (у рамы зазор 8–10 мм, планки под подрезанные откосы/коробку; шов у рамы закрывает отрезок плинтуса вертикально поперёк проёма, 703 мм). ИК-плёнка на ступень не заводится. Торец среза (123×703, смотрит в комнату) — зона квартиры: краска или ПВХ-уголок 25×25 в тон.
Откосы двери и окна — полосы МДФ Stella 140 мм на монтажную пену (вторым пистолетом, снизу опираются на ступень), к раме — зазор 2–3 мм под белый акриловый герметик; углы — уголок МДФ Stella в тон панелей (7 шт, жидкие гвозди) → плинтус напольный (торцы задней стены в упор к откосам, подрезка 45°) → подключение блока (WAGO, лампы GX53), проверка света, розеток, экрана плёнки.

**Фаза 4 — Пуск тёплого пола (дни 8–10).**
Уставка терморегулятора 27 °C. Первое включение ступенчато: +5 °C в сутки первые трое.
