AndreyPlis/balcon/проект.md

# Лоджия — единый проект утепления и отделки

Материалы — Лемана ПРО, электрика — [electrolait.ru](https://electrolait.ru/) (Тверь). Цены — начало октября 2026 (потолок — 5 октября, инструменты — 3 октября).

Всего по проекту: материалы **89 769 ₽** + инструменты **15 158 ₽** = **104 927 ₽** (сверх того — монтажная пена частично в заказе Лемана; в наличии, не заказывается: 4× профиль CD 60×27 и бухта гофры ПВХ D20 — эквивалент 1 059 ₽; каркас — брусок 30×40, финиш стен и откосов — МДФ «Брисбен» + уголки, потолок — Venta 375, блоки — Legrand Quteo + Grand Meyer MST-1). Сводный заказ по магазинам после сверки с Петровичем — раздел 7.4: **101 142 ₽** (электрика — Электролайт, PIR «Баня» Г1 и клей-пена LOGICPIR — фирменный магазин ТН в Твери (tstn.ru: пена −25%, PIR на Лемане Тверь закончился), уровень + правило СИБРТЕХ + скотч — ВсеИнструменты, брусок и мелочь — Лемана, остальное — приоритет Петрович). Порядок работ — в отдельном файле [план работ.md](план работ.md). Полная смета — раздел «Смета» внизу, альтернативы — раздел «Альтернативы» в конце.

## 1. Помещение

- Габариты до отделки: **2791 × 1077 × 2806 мм** (замеры — [loggia_params.md](loggia_params.md)); площадь пола 3,01 м², объём 8,43 м³.
- После обшивки стен: ширина **2618 мм**, глубина **1017 мм**, площадь пола **2,663 м²** (потеря 0,343 м², 11,4%).
- Чистый пол ≈ **136–137 мм** от плиты (по слоям 136,6; после ГВЛВ перемерить лазером); до низа стекла (160 мм) запас ~23 мм.
- Панорамное остекление: Melke Evolution 70 (ПВХ), стеклопакет 4-14-4-14-4i (одно i-стекло), U ≈ 1,4 Вт/м²·К.
- Входной блок: дверь 703×2258 (порог +230, полотно на +280), окно 734×1570, простенок справа ~1229, над проёмом 307–320.
- Конструктив: боковые стены — кирпич 120 мм (к тёплым соседям), задняя — кирпич 300 мм (стена дома); пол и потолок — ж/б плиты.

## 2. Потолок

Схема: PIR 50 мм фольгой вниз на клей-пене + 12 термодюбелей (они же держат каркас — подвесы зажимаются тарельчатыми головками) → 3 профиля CD/ПП 60×27 вдоль длинной стены на 12 прямых подвесах, отгиб ножек 23–25 мм → панели ПВХ к нижним полкам профиля → встраиваемые GX53 в полости 50 мм. Кабель 3×1,5 в гофре ПВХ D16 вводится в левом заднем углу, лежит на фольге. Панели до рамы, 10 мм до стекла.

### Примечания к монтажу

- Термодюбель Sormat 8×155: 50 мм PIR + ~105 мм в бетон. Сверлится сквозь плиту одним бурением, основание подвеса заводится под тарельчатую головку — тарелка прижимает подвес к фольге, и каждый из 12 дюбелей держит и утеплитель, и каркас, лишних отверстий и мостиков холода нет (сталь подвеса целиком в тёплой зоне, под тарелкой и термоголовкой). Шляпка с термоголовкой заклеивается алюминиевым скотчем. Бур 8×170 мм и длиннее — короткий 110 мм не пройдёт сквозь утеплитель. Перед забиванием перемерить фактическую длину: нужно ≥ 155 мм при слое PIR 50 мм.
- Каркас: ножки подвесов отогнуть на 90° пассатижами (жёсткий угол), отгиб 23–25 мм от фольги по лазеру — полость фольга→панель = отгиб + 27 мм (высота CD) = 50 мм, как расчётная для GX53 и гофры. Профиль заводится между ножками, скрутка клопами 3,5×9,5 по 2 с каждой стороны (4 на подвес: один клоп даёт профилю провернуться, два фиксируют жёстко). Торчащие концы ножек ниже профиля отогнуть вверх вдоль ножки или откусить бокорезами.
- Клей-пена — разомкнутыми полосами; один пистолет под клей-пену, второй под монтажную, не смешивать.
- Отверстия в панели под GX53 Ø90 мм резать между профилями, кабель заводить сбоку, не под корпус.
- Швы PIR и каждую шляпку дюбеля — алюминиевым скотчем (толстым, тонкий рвётся).
- Панели крепятся саморезами в паз замка под углом — шляпки скрыты следующей панелью, через лоб не крутить (острые ЦКИ 4,2×25 прокалывают оцинковку 0,6 мм без засверливания). Краевые ламели у стены и у рамы — саморезом в профиль, шляпку прикрыть по вкусу. Стартовый профиль не используется. Стык потолочных и стеновых панелей — встык, потолочный плинтус не используется.
- Кабель тянется в гофре ПВХ D16 (самозатухающая) с протяжкой: трасса от ввода в левом заднем углу по фольге между профилями до каждого светильника. Гофра в полости 50 мм проходит свободно, к PIR не крепится — лежит на фольге и прижимается профилями и панелями.
- Панель у рамы опускается до глухой части, до стекла оставляется ~10 мм.

## 3. Стены

### Конструкция

| # | Слой | Боковые (к тёплым соседям) | Задняя (стена дома) |
|---|---|---|---|
| 1 | Кирпич | 120 мм | 300 мм |
| 2 | Клей-пена Logicpir, разомкнутые полосы | — | — |
| 3 | PIR ф/ф (Logicpir 600×1200), 2 дюбеля/плита, швы и шляпки под алюминиевым скотчем | 50 мм | 30 мм |
| 4 | Брусок строганый 30×40 на клей-пене к фольге, шаг 400, все стены (40 к PIR, 30 от стены — полость под гофру D20) + антисептик-огнебиозащита | 30 | 30 мм |
| 5 | Панель МДФ Stella «ледяное дерево» 2700×200×6, матовая белая ([petrovich.ru](https://tver.petrovich.ru/product/1079995/)), горизонтальная укладка (15 рядов, подрезка до ~187), крепление в паз к бруску | 6 мм | 6 мм |
| | **Итого** | **86 мм** | **66 мм** |

**Габариты после стен:** ширина 2619 мм, глубина 1011 мм, площадь пола 2,648 м² (потеря 0,358 м², 11,9%).

**Электрика** (ввод один — 3×2,5, простенок слева от окна: ось 80 мм от левой стены, Z=2488 у верха окна — вне пирога левой стены 80 мм; отверстие Ø25, фольга заклеивается скотчем):
- трасса ввода: от розетки в комнате (шлейф, с PE) → по полости задней стены поверх PIR (между брусками) → потолочная полость → распаячная коробка EKF 80×50×80 (WAGO внутри)
- от коробки — три ветки: **свет** 3×1,5 по потолочной полости к трём GX53 + линия к выключателю на задней стене; **розетки** 3×2,5 по левой стене поверх PIR под потолком со спуском к блоку; **тёплый пол** 3×2,5 к Grand Meyer MST-1 (задняя стена, справа от входа), от него к плёнке (PE ввода — на экран ИК-плёнки; защита — существующие автомат и УЗО линии розетки)
- блоки — **накладной монтаж, корпуса вертикально на рейках** (крепёж сквозь панель в брусок): розетки — левая стена, **тройной блок Legrand Quteo 782238** на рейке LatL_2 (ось Y=600, Z≈780–1020); **выключатель и терморегулятор Grand Meyer MST-1** — задняя стена справа от входа, вертикально друг над другом на рейке (ось X=1800, за дверным откосом: выключатель Z=900, MST-1 Z=1000). Подрозетники и закладные не нужны. Датчик пола — гофра от MST-1 вниз по задней полости, далее канавка в подложке
- питание — шлейфом от розетки в комнате через вводное отверстие Ø25: ввод один 3×2,5 с PE, в гофре D20 сквозь стену до распаячной коробки — кабель заменяем; PE обязателен — на него сажается экран ИК-плёнки; защита — существующие автомат и УЗО линии этой розетки; зазор вокруг гофры после прокладки заделать монтажной пеной

**Откосы** входного блока (тёплая сторона): полосы МДФ Stella «ледяное дерево» 140×2700 (продольный раскрой панелей, ~9,1 м периметра двери и окна) на пену, примыкание к раме — в упор с зазором 2–3 мм, шов — **белый акриловый герметик** (F-профиль убран). Углы стен и примыкания откосов — **уголок МДФ Stella складной 24×24 в тон панелей** на жидкие гвозди (5,6 + 9,1 м = 7 шт); панели за уголком стыкуются в упор с зазором 2–3 мм. Толщина та же 6 мм — пирог стен не меняется (86/86/66).

### Примечания к монтажу

- PIR клеится от угла панорамы, вразбежку, сутки до дюбелей. Дюбели: остатки Sormat 8×155 (18 шт) + тарельчатые 10×90.
- Каркас стен: **брусок строганый 30×40** (хвоя, сорт Оптима, ФГИС ЛК, Лемана ПРО), вертикально, шаг ≤400; над окном/дверью и под окном — вертикальные вставки, продолжающие сетку. Узкий простенок слева от окна (~125 мм) — без стойки: лист на клей-пене к PIR. Полость 30 — гофра D20 проходит свободно. Брусок заранее пропитать антисептиком-огнебиозащитой (сутки сушки), полка 40 — на клей-пену Logicpir полосой на всю ширину, прижимать правилом и фиксировать малярным скотчем до полимеризации (сутки). Несущим каркас не считается — только лёгкая обшивка; панели крепить саморезами по дереву.
- Отделка стен — панели МДФ Stella «ледяное дерево» 2700×200×6 горизонтально (15 рядов с подрезкой по высоте, куски без стыков). Клей не используется: крепление саморезами в паз к бруску, от угла; торцы панелей во внутренних углах прикрыть раскладкой/плинтусом.
- Блоки накладные, корпуса вертикально на рейках: тройной блок Legrand Quteo с/з — левая стена, на LatL_2 (ось Y=600, Z≈780–1020); выключатель (Z=900) + Grand Meyer MST-1 (Z=1000) — задняя стена справа от входа на рейке (ось X=1800, LatB_R1), крепёж сквозь панель в брусок. Гофра датчика — от MST-1 вниз, дальше провод датчика в канавке подложки.
- Откосы: МДФ Stella на пену; примыкание к раме — зазор 2–3 мм под белым акриловым герметиком (F-профиль убран 08.10 — пластик в узле не нужен, паз профиля к тому же на панель 10 мм, а МДФ 6 мм).
- Плинтус напольный ПВХ по низу стен (3 шт в корзине, периметр 3,95 м с углами), у стыка с полом закроет край листов.
- Подоконник: старый снять, новый ПВХ 200 мм глубиной ставится от рамы поверх утеплённой стены (опора — откос и левый простенок), подрезка по месту до ~870 мм.

## 4. Пол

### Конструкция (сухой пирог, без мокрых процессов)

| # | Слой | Толщина |
|---|---|---|
| 1 | Плита (сбить наплывы >10 мм, пропылесосить) | — |
| 2 | Клей-пена Logicpir | ~3 мм |
| 3 | PIR 50 ф/ф Logicpir, слой 1, швы под скотч | 50 мм |
| 4 | Клей-пена | ~3 мм |
| 5 | PIR 50 ф/ф, слой 2, швы вразбежку ≥200 мм, под скотч | 50 мм |
| 6 | Клей-пена | ~3 мм |
| 7 | ГВЛВ Кнауф Суперпол 600×1200×20, фальц, с зазором 3 мм | 20 мм |
| 8 | Подложка отражающая EVA с фольгой 3 мм, стыки скотчем | 3 мм |
| 9 | Датчик пола Rexant (в канавке подложки, между греющими полосами) | — |
| 10 | ИК-плёнка Rexant 2,5 м² 550 Вт (220 Вт/м²) | 0,4 мм |
| 11 | Техплёнка ПЭ армированная 200 мкм | — |
| 12 | SPC кварцвинил **Corsa Deco Laguna B300** замковый, с фаской и подложкой IXPE ([petrovich.ru](https://petrovich.ru/product/1133918/)) | 5,3 мм |
| | **Итого пирог** | **~136 мм** |

Отметка чистого пола ≈136–137 мм от плиты (сумма слоёв 136,6; пена сминается — по факту перемер лазером после ГВЛВ): до стекла (160 мм) запас ~23 мм. Ступень срезается до ~130 мм от плиты — на 100 мм ниже исходных 230.

**Числа ступени приведены к одному варианту:** срез до ~107 мм от плиты (−123 мм) — на ступень заходит продолжение пирога пола: клей-пена ~3 + ГВЛВ 20 (подрезка из запаса) + подложка 3 + SPC 5,3 ≈ 137,9 = чистый пол, вход без порога; ИК-плёнка на ступень не заводится. Торец среза 123×703; зазор под дверным полотном ~143 мм. Финальную отметку среза выводить лазером от готового ГВЛВ (чистый пол − 3 мм пены − 20 мм ГВЛВ − 3 мм подложки − 4 мм SPC).

Выравнивание — пена: полосы разной толщины по лазеру, каждый лист прижимается и проверяется по лучу; второй слой и ГВЛ — тем же приёмом. Стяжка не нужна.

### Примечания к монтажу

- Порядок: сбить наплывы → пылесос → PIR слой 1 на пену по лазеру → сутки → слой 2 вразбежку → ГВЛВ на пену, фальц, зазор 3 мм, пригруз на сутки → подложка → плёнка → SPC.
- Швы обоих слоёв PIR и периметр пола — алюминиевым скотчем: пол замыкает пароизоляцию контура снизу.
- ИК-плёнку резать только по линиям отреза, торцы — битумные изоляторы из комплекта; PE-экран плёнки — на заземляющую жилу линии тёплого пола.
- Датчик Rexant: гофра ведётся от блока только до пола, дальше провод датчика без гофры — в подложке прорезается канавка 5×5 мм под провод, датчик между греющими полосами в 20 см от края зоны, сверху скотч.
- Уставка терморегулятора — 27 °C. Первое включение ступенчато: +5 °C в сутки первые трое.
- SPC плавающий, зазор от стен 8–10 мм, у порога двери — переходный профиль. Corsa Deco идёт с заводской подложкой IXPE — слой над ИК-плёнкой +1 мм к прежнему решению (прогрев чуть медленнее); отражающая подложка Isolon остаётся под плёнкой. Чистый пол ≈137,9 мм.
- Ступень в откосе двери: грубый срез основной массы в подготовительный день (до ~117 мм, с запасом 10 мм), финишная доводка до ~107 мм от плиты лазером от готового ГВЛВ (чистый пол − 3 мм пены − 20 мм ГВЛВ − 3 мм подложки − 5,3 мм SPC). Ступень — **продолжение пирога пола**: на срез клей-пена, кусок ГВЛВ из подрезки, подложка EVA, SPC в замок от пола через ступень до рамы блока. У рамы оставить температурный зазор 8–10 мм, планки завести под откосы/коробку (подрезать снизу на ~10 мм); шов у рамы закрывает отрезок плинтуса, поставленный вертикально поперёк проёма (703 мм, запас в 3 шт × 2200 есть). Вход без порога, верх ступени = чистый пол (~137 мм). ИК-плёнка на ступень не заводится.
- Торец среза ступени (вертикаль 123×703, смотрит в комнату) — зона квартиры: краска или ПВХ-уголок 25×25 в тон, по месту.
- Откосы двери (Venta, глубина 140) снизу опираются на SPC ступени, подрезка по месту. Плинтус задней стены прерывается проёмом: торцы в упор к откосам, подрезка 45°.
- Зазор под дверным полотном после среза ступени — ~143 мм (полотно на +280, чистый пол ≈137). Дверь внутренняя, сквозняк не критичен; при желании — щёточный уплотнитель на низ полотна.

## 5. Инструменты

Для утепления и отделки лоджии. В сметы конструкций не входят. Цены — 3 октября 2026, диски — 6 октября 2026, буры — 7 октября 2026, чашка — 12 октября 2026 (замены по отзывам, см. примечание под таблицей).

### Покупать

| # | Инструмент | Зачем | Цена, ₽ | Ссылка |
|---|---|---|---|---|
| 1 | Бур по бетону SDS-plus Rage Quadro-X 566821 8×210 мм, 2 шт. (4,5/5, 179 отзывов) — **куплены 13.10** | 12 отверстий на потолке сквозь PIR + бетон, подвес заводится под тарельчатую головку (короткий 110 мм не пройдёт); у бюджетных буров напайка иногда отваливается на 3–7-м отверстии — второй бур страховка | 267/шт | [lemanapro.ru](https://lemanapro.ru/product/bur-po-betonu-sds-plus-rage-quadro-x-566821-8x210-mm-89383430/) |
| 2 | Бур по бетону SDS-plus 10×160 мм, 2 шт. (46 отзывов) — **куплены 13.10** | тарельчатые дюбели 10×90 на стенах, ~16 отверстий (2 на плиту сверх 18 остатков Sormat); второй — страховка | 114/шт | [lemanapro.ru](https://lemanapro.ru/product/bur-po-betonu-sds-plus-10x160-mm-89383380/) |
| 3 | Пистолет для монтажной пены Вихрь 73/3/6/6, 2 шт. — №1 **куплен 13.10**, №2 — к Д7 (монтажная) | первый — клей-пена Logicpir (профессиональный баллон), второй — монтажная пена для откосов; в одном пистолете не смешивать | 676/шт | [lemanapro.ru](https://lemanapro.ru/product/pistolet-dlya-montazhnoy-peny-vihr-73-3-6-6-85088621/) |
| 4 | Набор коронок по дереву Matrix 64–127 мм, 8 шт | вырезы Ø90 под GX53 (коронка 89 мм + доводка ножом) и на будущее | 561 | [lemanapro.ru](https://lemanapro.ru/product/nabor-koronok-po-derevu-matrix-704715-64-127-mm-87657902/) |
| 5 | Уровень лазерный Ermenrich LT20 (2 линии, 15 м) | выставить 3 профиля CD в одну плоскость | 1 890 | [lemanapro.ru](https://lemanapro.ru/product/uroven-lazernyy-ermenrich-lt20-84635-92088726/) |
| 6 | Бур по бетону SDS-plus Rage 562560 25×600 мм (4,5/5, 105 отзывов) — **куплен** | сквозное отверстие под гофру D20: ввод в гофре сквозь стену — кабель заменяем; Ø25 = наружный Ø гофры +25%, Ø20 гофре мало; по отзывам стену ~400 мм проходит — сверлить с перерывами (5 с работа / 10–15 с охлаждение), беречь напайку от арматуры | 1 780 | [lemanapro.ru](https://lemanapro.ru/product/bur-po-betonu-sds-plus-rage-562560-25x600-mm-89369128/) |
| 7 | Диск отрезной по металлу Сибртех 743147 125×22,2×1,2 мм, 3 шт (1013 отзывов) — **куплены 13.10** | тонкий диск под профиль 0,5–0,6 мм — ровный рез без нагрева; УШМ уже есть, покупаем только диски | 27/шт | [lemanapro.ru](https://lemanapro.ru/product/disk-otreznoy-po-metallu-sibrteh-743147-125x222x12-mm-88022834/) |
| 8 | Диск алмазный по бетону Rage 600132 сегментный 125×22,2×2,2 мм — **куплен 07.10** | борозда по периметру среза ступени — ровный край без сколов, затем перфоратор | 876 | [lemanapro.ru](https://lemanapro.ru/product/disk-almaznyy-po-betonu-rage-600132-segmentnyy-125x222x22-mm-89435058/) |
| 9 | Пика по бетону SDS-plus 250 мм (47 отзывов) — **куплена** | отбойник: крошить бетон ступени точечно (если нет в комплекте перфоратора) | 161 | [lemanapro.ru](https://lemanapro.ru/product/pika-po-betonu-sds-plus-250-mm-86407420/) |
| 10 | Зубило лопаточное SDS-plus 40×250 мм (46 отзывов) — **куплено** | отбойник: срывать слои среза ступени по плоскости | 188 | [lemanapro.ru](https://lemanapro.ru/product/zubilo-lopatochnoe-sds-plus-40x250-mm-86508679/) |
| 11 | Уровень магнитный усиленный Зубр «Профессионал-М» 1000 мм с зеркальным глазком (34589-100_z01; ВсеИнструменты, наличие проверить при заказе) | магнит липнет к CD-профилям, зеркальный глазок — чтение колбы при работе над головой (потолок); усиленный профиль; контроль бруска каркаса, ряды МДФ | 2 257 | [vseinstrumenti.ru](https://www.vseinstrumenti.ru/product/magnitnyj-usilennyj-uroven-zubr-professional-m-1000-mm-s-zerkalnym-glazkom-34589-100-z01-1717052/) |
| 12 | Правило алюминиевое трапеция с рёбрами жёсткости СИБРТЕХ 89602, 1,5 м (114 отзывов; ВсеИнструменты, самовывоз с 15.10 — заменено 13.10 с Hesler 2,5) | прижим бруска каркаса (3–4 стойки пролётом; заднюю стену 2619 — в два приёма), поперечный рез Venta/PIR; продольный рез МДФ 2700 — по бруску 30×40×3000 как направляющей | 929 | [vseinstrumenti.ru](https://www.vseinstrumenti.ru/product/alyuminievoe-trapetsievidnoe-pravilo-s-rebrami-zhestkosti-1-5-m-sibrteh-89602-543315/) |
| 13 | Чашка алмазная двухрядная по бетону Vira 592035 125×22,2 мм (19 отзывов) — **куплена 13.10** | к УШМ (уже есть): шлифовка плиты пола — снять мелкие наплывы и глянец перед сухим пирогом; двухрядная — ровный след, без биения (у турбо-версии 592036 есть жалобы на дисбаланс) | 558 | [lemanapro.ru](https://tver.lemanapro.ru/product/chashka-almaznaya-dvuhryadnaya-po-betonu-vira-592035-125x222-mm-89418165/) |
| | **Итого** | | **11 395** (куплено: диск 876 ₽ — 07.10, пика 161 ₽, зубило 188 ₽, бур 25×600 1 780 ₽ — 3 005 ₽; 13.10 — диски отрезные 81 ₽, пистолет №1 676 ₽, буры 8×210 — 534 ₽ и 10×160 — 228 ₽, чаша Vira 558 ₽; итого куплено 5 082 ₽; осталось докупить на 6 313: лазер LT20 1 890, уровень Зубр 2 257, правило СИБРТЕХ 929, коронки Matrix 561, пистолет №2 676) | |

Буры обновлены 07.10 по отзывам Лемана ПРО: Энкор 25×600 снят с продажи (404) → Rage 562560 — единственный 25×600 с базой отзывов (+1 220 ₽); Курс 8×210 (0 отзывов) → Rage Quadro-X 8×210 ×2 (+54 ₽); бур 10 мм добавлен в смету — SDS-plus 10×160 ×2 (+228 ₽). Альтернативы 25×600 без отзывов: Cutop 40-25600 (2 184 ₽), Cutop 49-25600 (2 322 ₽), Shyld 40740 (4 600 ₽), D.Bor 4C Plus по железобетону (2 119 ₽, 2 отзыва).

##### Аналоги на petrovich.ru — Инструменты (СПб, 08.10.2026)

| # | Аналог | Цена | К смете | Ссылка |
|---|---|---|---|---|
| 1 | Тот же Rage Quadro-X 8×210 (566821) / Практика Профи 8×210 / Hesler 8×210 | 297 / 199 / 111 ₽ | Лемана 267 ₽ — там и брать | [petrovich.ru](https://petrovich.ru/product/1172689/) |
| 2 | Бур 10×160 в выдаче нет | — | ✗ | — |
| 3 | Пистолет Сибртех 88678 / Hesler 675307 | **599 / 552 ₽** ✓ | ✓ −77…−124 ₽/шт к Вихрю 676 | [petrovich.ru](https://petrovich.ru/product/1147967/) |
| 4 | Набор Практика 773-279 d19–127, 12 шт (состав на Ø89–90 проверить) / Kranz d19–64 (без 90) | 1 509 / 734 ₽ | ✗ дороже Matrix 561 | [petrovich.ru](https://petrovich.ru/product/132445/) |
| 5 | Condtrol QB green (зелёный луч) | 2 990 ₽ | ✗ дороже Ermenrich 1 890 | [petrovich.ru](https://petrovich.ru/product/675164/) |
| 6 | Практика Профи 25×600 (038-135) | 1 875 ₽ | ✗ +95 ₽ к Rage 1 780 | [petrovich.ru](https://petrovich.ru/product/139918/) |
| 7 | Круг Луга 125×22,2×1,2 (8064) | 27 ₽ ✓ | ~ равно | [petrovich.ru](https://petrovich.ru/product/134039/) |
| 9 | Зубило пикообразное SDS-plus КМ 250 | 163 ₽ ✓ | ~ равно (161→163) | [petrovich.ru](https://petrovich.ru/product/815745/) |
| 10 | Зубило плоское Практика 40×250 (034-137) | 252 ₽ | ✗ +64 ₽ | [petrovich.ru](https://petrovich.ru/product/504213/) |

Инструменты: выгода только на пистолетах (−154…−248 ₽ на пару); буры и лазер на Лемане выгоднее.

### Основной инструмент

| Инструмент | Зачем |
|---|---|
| Перфоратор SDS-plus | 12 отверстий под термодюбели; сбить наплывы бетона на плите |
| Шуруповёрт + бита PH2 | 84 самореза в пазы ламелей + клопы 3,5×9,5: профиль к подвесам |
| Дрель или тот же шуруповёрт | работа коронкой Ø90 по ламелям |
| УШМ (уже есть) + отрезной диск 125×1,2 (покупка, см. таблицу выше) | профиль CD 3000 → 3 профиля по ~2618 мм (2791 − 83 − 83 обшивок боковых стен); брусок стен 30×45 — торцовкой/ножовкой |
| Строительный нож с запасными лезвиями (основной рез по пластику и МДФ — лезвий взять с запасом) | весь пластик и МДФ: панели Venta и МДФ 6 мм по правилу в несколько проходов, откосы Venta 10 мм; подрезка PIR по месту, вскрытие скотча, доводка вырезов, фаски |
| Рулетка 3–5 м + карандаш/маркер | разметка плит, профилей, ламелей, точек сверления |
| Угольник | разметка поперечных резов ламелей под 90° |
| Лазерный уровень | единая плоскость трёх профилей; заодно разметка стен и пола |

### Электрика

| Инструмент | Зачем |
|---|---|
| Кусачки или стриппер | зачистка жил кабеля 3×1,5 |
| Клеммы WAGO 221 (3–4 шт.) | соединения кабель–светильник в полости, скрутки не делать |
| Индикаторная отвёртка | проверить отсутствие фазы перед подключением |
| Изолента | подстраховка маркировки жил |

### Отделочные и вспомогательные

| Инструмент | Зачем |
|---|---|
| Пассатижи + бокорезы | отгиб ножек прямых подвесов под 90°, обрезка торчащих концов — узел подвес/CD на потолке |
| Шпатель или ровная рейка | прижимать скотч к фольге без пузырей |
| Пресс для пистолета не нужен, но промывка для пистолета — пригодится | если пена встанет в пистолете между работами |
| Стремянка 5 ступеней или козлы + настил | потолок на высоте 2,8 м, все работы над головой |
| Пылесос (куплен) или веник | бетонная крошка после сверления, пыль от резки |

### Защита

| Средство | Зачем |
|---|---|
| Очки | сверление потолка — крошка сыпется в глаза; искры при резке профиля УШМ |
| Респиратор | пыль от резки PIR и бетона |
| Перчатки | пена, резка профиля, монтаж — руки беречь |
| Старая одежда/фартук | пена не отстирывается |

### Расходники, докупить сразу

Запасные лезвия ножа (много — нож теперь режет весь пластик), промывка для пистолета пены, изолента, малярный скотч для временной фиксации, мешки для мусора (клеммы WAGO — уже в смете потолка).

## 6. Остатки и передача между разделами

- **Термодюбели Sormat 8×155** (уп. 30 шт, смета потолка): 12 — на потолок, 18 — на дюбелировку PIR стен.
- **Скотч алюминиевый Unibob**: потолок → стены (швы, шляпки) → остаток на швы и периметр пола.
- **Саморезы ЦКИ 4,2×25**: пачка потолка (84 точки) → остаток ~88 шт на стены.
- **Гофра ПВХ, самозатухающая (не поддерживает горение)**: D20 (12 м) — трассы 3×2,5 (ввод→коробка, розетки, тёплый пол); D16 (10 м) — свет потолка, остаток — до датчика пола (в канавке подложки провод без гофры). ПВХ выбрана вместо мягкой ПНД осознанно: за горючей обшивкой (панели ПВХ, PIR) гофра не должна распространять горение — ПНД горит, ПВХ самозатухает. На острых срезах профиля концы обмотать изолентой, тянуть не внатяг. 3×2,5 в D16 не протягивается: плоский кабель ~13×6 мм шире прохода D16 (~10,7 мм). При заказе уточнить у продавца зонд (стальная протяжка).
- **Терморегулятор GM-119, рамка и розетки Valena, плинтус напольный** — в смете стен (вторым постом рамки — регулятор пола).
- **SPC**: кусок 703×150 из остатка коробки — на ступень у двери.

## 7. Смета

### Сводка по бюджету

| Раздел | Сумма, ₽ |
|---|---|
| Потолок | 14 822 |
| Стены | 37 781 (без монтажной пены) |
| Пол | 29 400 |
| **Материалы итого** | **80 003** |
| Инструменты (перечень — раздел «Инструменты»; куплено 3 005 ₽: диск, пика, зубило, бур 25×600) | 11 944 |
| **Всего по проекту** | **91 947** |

В наличии (в суммы не входит, не заказывается): профиль ПП/CD Knauf 60×27×3000 — **4 шт.** (3 в работу + 1 запас), гофра ПВХ D20 самозатухающая — бухта, куплена в Д0.

Аналоги на petrovich.ru (СПб, 08.10.2026): потенциальная экономия до **~10 950 ₽** по позициям, где Петрович дешевле (F-профиль откосов, SPC, подложка, светильники GX53, WAGO, Venta) — подробные таблицы после корзин. PIR, профили ПН, ГВЛВ, кабель и гофра на Петровиче дороже.

Бюджетный вариант потолка ≈ 11 500 ₽ (Fastfix 750 мл ×3 вместо Logicpir, светильники 78 ₽, профиль Standers, подвесы Премиум, кабель 5 м без резерва на выключатель) — тогда весь проект ≈ 86 600 ₽.

### 7.1. Потолок — корзина

| # | Позиция | Кол-во | Цена, ₽ | Сумма, ₽ | Ссылка |
|---|---|---|---|---|---|
| 1 | PIR Logicpir Баня ф/ф Г1 L-кромка 1190×590×50 (5 листов = 3,51 м²; общий заказ 5 уп — tstn, на Лемане Тверь нет в наличии) | 1 уп | 4 329 | 4 329 | [tver.tstn.ru](https://tver.tstn.ru/product/logicpir-banya-f-f-g2-l-1190kh590kh50/) |
| 2 | Клей-пена Технониколь Logicpir для плит PIR, 1000 мл — фирменный магазин ТН (tstn, 1 414 ₽/балл) | 2 шт. | 1 414 | 2 828 | [tver.tstn.ru](https://tver.tstn.ru/product/kley-pena-tekhnonikol-logicpir-1000-ml/) |
| 3 | Термодюбель Sormat для теплоизоляции, гвоздь с термоголовкой 8×155 мм, 30 шт. (нужно 12) | 1 уп. | 658 | 658 | [lemanapro.ru](https://lemanapro.ru/product/dyubel-dlya-teploizolyacii-sormat-gvozd-s-termogolovkoy-8x155-mm-30-sht-89397658/) |
| 4 | Лента алюминиевая Unibob 50 мм × 40 м — ВсеИнструменты | 1 шт. | 740 | 740 | [vseinstrumenti.ru](https://www.vseinstrumenti.ru/product/alyuminievaya-klejkaya-lenta-unibob-50-mm-h-40-m-134860-1103742/) |
| 5 | Профиль потолочный (ПП/CD) Knauf 0,6 мм 60×27×3000 мм — **в наличии 4 шт.** (3 в работу + 1 запас) | 4 шт. | — | — | не заказывается |
| 6 | Подвес прямой Knauf 120 мм для профиля 60×27 | 12 шт. (по 4 на профиль) | 14,5 | 174 | [lemanapro.ru](https://lemanapro.ru/product/podves-pryamoy-knauf-120-mm-dlya-potolochnogo-profilya-60x27-mm-82632743/) |
| 7 | Саморезы-клопы DILWIS по металлу оцинкованные острые 3,5×9,5 мм, на вес (4 шт × 12 подвесов + запас) | ~0,06 кг (~60 шт) | 528/кг | 32 | [lemanapro.ru](https://lemanapro.ru/product/samorezy-po-metallu-dilwis-ocinkovannye-ostrye-35x95-mm-na-ves-89384754/) |
| 8 | Стеновая панель ПВХ Белая реечная 3000×100×10 мм (3,9/5, 185 отзывов; 28 кусков по 1077 мм + 1 запас на брак при резке) | 15 шт. | 138 | 2 070 | [lemanapro.ru](https://lemanapro.ru/product/stenovaya-panel-pvh-belaya-3000x100x10-mm-03-m-17164298/) |
| 9 | Светильник встраиваемый Wolta Luce WDL-GX53/06W-S, отверстие 90 мм | 3 шт. | 653 | 1 959 | [lemanapro.ru](https://lemanapro.ru/product/svetilnik-tochechnyy-vstraivaemyy-wolta-luce-wdl-gx53-06w-s-pod-otverstie-90-mm-gx53-cvet-belyy-92030646/) |
| 10 | Лампа светодиодная Smartbuy GX53 10 Вт, 4000К | 3 шт. | 90 | 270 | [electrolait.ru](https://electrolait.ru/shop/lampy/svetodiodnye/gx53/lampa-svetodiodnaya-61-191-oll-gx53-12-230-4k-onlajt-61191/) |
| 11 | Кабель ВВГ-Пнг(А) 3×1,5 ГОСТ, Дмитровкабель (ветвь света от коробки: GX53 + клавиша) — **куплен** | 10 м | 80 | 800 | [electrolait.ru](https://electrolait.ru/shop/kabel/vvg/vvg-pnga-3h15-dmitrov-kabel-gost/) |
| 12 | Саморезы универсальные ЦКИ с прессшайбой острые фосфатированные 4,2×25 мм, 200 шт. (84 точки: 28 ламелей × 3 профиля + запас) | 1 уп. | 505 | 505 | [lemanapro.ru](https://lemanapro.ru/product/samorezy-universalnye-cki-s-pressshayboy-ostrye-fosfatirovannye-42x25-mm-200-sht-92613264/) |
| 13 | Труба ПВХ гофрированная D16 мм, самозатухающая (нг; при заказе уточнить зонд) | 10 м | 10 | 100 | [electrolait.ru](https://electrolait.ru/shop/prokladka-kabelya/gofra/truba-pvh-gofrirovannaya-diametr-16mm/) |
| 14 | Клемма WAGO без пасты на 3 провода (свет: ввод, продолжение, светильник + 2 на разветвление в коробке) | 6 шт. | 66 | 396 | [electrolait.ru](https://electrolait.ru/shop/klemniki/wago-klemma-b-pasty-na-3-provoda/) |
| 15 | Коробка распределительная EKF 80×50×80 мм IP54 (распаячная в потолочной полости, WAGO внутри) | 1 шт. | 96 | 96 | [lemanapro.ru](https://lemanapro.ru/product/raspredelitelnaya-korobka-ekf-80x50x80-mm-ip54-cvet-chernyy-92974828/) |
| | **Итого, потолок** | | | **14 822** | |

Металлокаркас вместо брусков вышел почти в ту же цену (−1 260 ₽ брус + антисептик не нужен, +1 109 ₽ профиль/подвесы/клопы), но пропускает сутки сушки антисептика и убирает горючее дерево из пирога. Дерево убрано из проекта полностью: каркас стен — тоже металлический (ПН 27×28, см. раздел «Стены»), антисептик исключён из корзины.

Электрика (кабель, гофра, лампа GX53, клеммы) — Электролайт. Кабель берём только с пометкой ГОСТ: ВВГ-Пнг(А) Дмитровкабель, нарезка метрами. Встраиваемого корпуса GX53 на сайте нет, рамки Wolta остаются с Лемана.

##### Аналоги на petrovich.ru — Потолок (СПб, 08.10.2026)

| # | Аналог | Цена | К смете | Ссылка |
|---|---|---|---|---|
| 1 | Logicpir **Баня** 50×590×1190 (фольга; 600×1200 нет) | 909 ₽/шт | ✗ дороже (671→909) | [petrovich.ru](https://petrovich.ru/product/1214673/) |
| 2 | Клей-пена Logicpir нет; Технониколь 500 Professional 600 мл / Penoplex Fastfix 750 | 653 / 718 ₽ | ✗ объём меньше | [petrovich.ru](https://petrovich.ru/product/683559/) |
| 3 | Sormat 8×155 нет; Daxmer 10×140 пластик 30 шт / Tech-Krep 10×140 термоголовка 60 шт | 249 ₽ / 1 390 ₽ | ~ равно / дороже за шт | [petrovich.ru](https://petrovich.ru/product/1063077/) |
| 4 | Изоспан FL Termo 50 мм×40 м | 665 ₽ | ✗ +54 ₽ | [petrovich.ru](https://petrovich.ru/product/614336/) |
| 5 | *(в наличии)* для справки: КМ Эксперт 60×27×3000 0,6 мм | 267 ₽/шт | дешевле Knauf 301 | [petrovich.ru](https://petrovich.ru/product/129583/) |
| 6 | Подвес прямой КМ Стандарт 60×27 0,9 мм / Knauf | 13 ₽ ✓ / 21 ₽ | ✓ дешевле (14,5→13) | [petrovich.ru](https://petrovich.ru/product/106240/) |
| 7 | Клопы «на вес» нет; Hard-Fix 4,2×25 усиленные 70 шт | 219 ₽ | ✗ дороже (32→219) | [petrovich.ru](https://petrovich.ru/product/977095/) |
| 8 | Stella 100×3000×8 — 154 ₽ → **выбрано 08.10: Venta 375×3000×8 глянец белая, 575 ₽/шт** ([1065311](https://petrovich.ru/product/1065311/)): 8 полос × 1077, 5 панелей с запасом = 2 875 ₽ | 575 ₽ | потолок ~равен (+565 ₽ к Stella, −7% к корзине 10 мм: меньше стыков) | [petrovich.ru](https://petrovich.ru/product/1065311/) |
| 9 | Navigator ДВО GX53 хром/чёрный хром IP20 | **125 ₽** ✓ | ✓ −528 ₽/шт (653→125); вырез ~90 мм проверить | [petrovich.ru](https://petrovich.ru/product/503717/) |
| 10 | Лампа Rev Ritter GX53 10 Вт 4000К | 93 ₽ | ~ равно (90→93) | [petrovich.ru](https://petrovich.ru/product/500085/) |
| 11 | ГОСТКАБЕЛЬ ВВГнг(А)-LS 3×1,5 | 108 ₽/м | ✗ дороже (80→108) | [petrovich.ru](https://petrovich.ru/product/770854/) |
| 12 | Универсальных ЦКИ нет; Hard-Fix 4,2×25 усиленные 250 шт | 619 ₽ | ✗ дороже (505→619) | [petrovich.ru](https://petrovich.ru/product/977093/) |
| 13 | Гофра ПВХ D16 лёгкая с зондом КМ, 10 м | 255 ₽ | ✗ дороже (100→255) | [petrovich.ru](https://petrovich.ru/product/984868/) |
| 14 | WAGO 2273-203 без пасты, 20 шт | **21 ₽/шт** ✓ | ✓ −45 ₽/шт (66→21) | [petrovich.ru](https://petrovich.ru/product/633615/) |
| 15 | Коробка Greenel 80×80×50 IP54 | 79 ₽ | ✓ дешевле (96→79) | [petrovich.ru](https://petrovich.ru/product/1005497/) |

Выгода по потолку: светильники −1 584, WAGO −268, подвесы −18, коробка −17 ≈ **−1 890 ₽**; PIR/кабель/гофра/саморезы — дороже.

### 7.2. Стены — корзина

| # | Материал | Кол-во | Цена, ₽ | Сумма, ₽ | Ссылка |
|---|---|---|---|---|---|
| 1 | PIR Logicpir Баня ф/ф Г1 L-кромка 1190×590×50 (боковые, ~6 м² — из общего заказа 5 уп; tstn) | 2 уп | 4 329 | 8 658 | [tver.tstn.ru](https://tver.tstn.ru/product/logicpir-banya-f-f-g2-l-1190kh590kh50/) |
| 2 | PIR Logicpir Баня ф/ф Г1 L-кромка 1190×590×30, уп. 8 плит = 5,62 м² (задняя; tstn — на Лемане Тверь нет в наличии) | 1 уп | 4 918 | 4 918 | [tver.tstn.ru](https://tver.tstn.ru/product/logicpir-banya-f-f-g2-l-1190kh590kh30/) |
| 3 | Клей-пена Технониколь Logicpir 1000 мл — tstn | 2 | 1 414 | 2 828 | [tver.tstn.ru](https://tver.tstn.ru/product/kley-pena-tekhnonikol-logicpir-1000-ml/) |
| 4 | Дюбель для теплоизоляции 10×90, 30 шт | 1 уп. | 177 | 177 | [lemanapro.ru](https://lemanapro.ru/product/dyubel-dlya-teploizolyacii-10x90-mm-30-sht-84039098/) |
| 5 | Скотч алюминиевый Unibob 50 мм × 40 м — ВсеИнструменты | 1 | 740 | 740 | [vseinstrumenti.ru](https://www.vseinstrumenti.ru/product/alyuminievaya-klejkaya-lenta-unibob-50-mm-h-40-m-134860-1103742/) |
| 6 | Брусок строганый 30×40×3000, хвоя, сорт Оптима, ФГИС ЛК ([lemanapro.ru](https://lemanapro.ru/product/brusok-stroganyy-30x40x3000-mm-celnyy-hvoya-sort-optima-fgis-lk-81947392/)) — каркас всех стен (аналог на Петровиче 30×45 — 268 ₽, дороже) | 12 | 193 | 2 316 |
| 6а | Антисептик-огнебиозащита для бруска, ~1,5 л | 1 | ~350 | 350 |
| 7 | — (ПН-2 убран 08.10: блок — накладной, полость 40 не нужна) | — | — | — |
| 8 | Панель МДФ Stella «ледяное дерево» 2700×200×6 ([petrovich.ru](https://tver.petrovich.ru/product/1079995/)) — финиш стен (~22 шт) + откосы 9,1 м (4 шт, продольный раскрой 140 мм) | 26 | 520 | 13 520 |
| 9 | Саморезы ЦКИ 4,2×25 с прессшайбой, 200 шт | 1 уп. | 505 | 505 | [lemanapro.ru](https://lemanapro.ru/product/samorezy-universalnye-cki-s-pressshayboy-ostrye-fosfatirovannye-42x25-mm-200-sht-92613264/) |
| 10 | Плинтус напольный ПВХ белый 2200 мм | 3 | 168 | 504 | [lemanapro.ru](https://lemanapro.ru/product/plintus-napolnyy-pvh-cvet-belyy-220x23x58-mm-89348887/) |
| 11 | Уголок МДФ Stella складной «ледяное дерево» 24×24×2700 ([petrovich.ru](https://tver.petrovich.ru/product/1080007/)) — углы стен (5,6 м) + примыкания откосов (9,1 м); на жидкие гвозди | 7 | 248 | 1 736 |
| 11а | Жидкие гвозди для уголков, тюбик | 1 | ~300 | 300 |
| 12 | Герметик акриловый Soudal «Моментальный» белый 280 мл ([petrovich.ru](https://petrovich.ru/product/140610/)) — швы откосов к раме ~9 м | 1 | 442 | 442 |
| 13 | Кабель ВВГ-Пнг(А) 3×2,5 ГОСТ, Дмитровкабель (ввод от розетки в комнате + ветви розеток и тёплого пола; расчёт 12,1 м, заказ с запасом) — **куплен** | 15 м | 123 | 1 845 | [electrolait.ru](https://electrolait.ru/shop/kabel/vvg/vvg-pnga-3h25-dmitrov-kabel-gost/) |
| 14 | Труба ПВХ гофрированная D20 мм, самозатухающая (нг; трассы 3×2,5: ввод→коробка, розетки, тёплый пол) — **в наличии**, куплена в Д0 (проверить: ПВХ нг, с зондом) | бухта | — | — | не заказывается |
| 15 | Выключатель накладной 1 кл., белый — приоритет Legrand Quteo 782201 (серия розетки; Петрович был недоступен 08.10 — цену проверить при заказе), запасной Makel/аналог | 1 | ~150 | 150 |
| 16 | Терморегулятор **Grand Meyer MST-1** накладной, датчик пола, белый ([Электролайт](https://electrolait.ru/shop/teplyj-pol/termoregulyatory/termoregulyator-mst-1-grand-meyer-belyj-gollandiya/), в наличии) — вместо Terneo stel (1 590 ₽, дозаказ отменён) | 1 | 770 | 770 |
| 17 | Розетка тройная **Legrand Quteo** накладная, белая, с заземлением ([petrovich.ru](https://petroviнуch.ru/product/824971/)) — блок на 3 поста одним корпусом; Schneider Prima нет в наличии, Makel ×3 (315 ₽) — запасной вариант | 1 | 471 | 471 |
| 18 | — (рамка не нужна: накладной монтаж) | — | — | — |
| 19 | — (подрозетники и закладные не нужны: накладной монтаж, крепёж по месту) | — | — | — |
| 20 | Подоконник ПВХ 1000×200 белый (замена: стена уходит внутрь на 62 мм, старый глубиной 135 короток) | 1 | 433 | 433 | [lemanapro.ru](https://lemanapro.ru/product/podokonnik-pvh-1000x200-mm-cvet-belyy-89193400/) |
| 21 | Монтажная пена профессиональная 750 мл под пистолет (откосы, заделка вводного отверстия) | 2 | — | — | цену и ссылку добавить при заказе |
| | **Итого, стены** | | | **37 781** + монтажная пена при заказе | |

Остатки потолочной сметы уходят на стены: 18 шт Sormat 8×155 (дюбели плит), остаток скотча, саморезы ЦКИ (остаток ~88 шт). Дерево и антисептик из проекта убраны: каркас стен — металл, как и потолка.

ВВГ берём с пометкой ГОСТ (ВВГ-Пнг(А), не LS). Рамка Valena на 5 постов: свет, GM-119, три розетки. Регулятор сделан под пост Valena, поэтому серия SEDNA здесь не встаёт. Пять коробок в ряд, 45 мм, посадочное место вырезается в PIR задней стены.

##### Аналоги на petrovich.ru — Стены (СПб, 08.10.2026)

| # | Аналог | Цена | К смете | Ссылка |
|---|---|---|---|---|
| 1–2 | PIR 50: Logicpir Баня 50×590×1190 — 909 ₽; **PIR 30 ф/ф нет** | 909 ₽/шт | ✗ дороже | [petrovich.ru](https://petrovich.ru/product/1214673/) |
| 3 | Logicpir нет; универсальный клей ТН 500 Professional 600 мл | 653 ₽ | ✗ объём меньше | [petrovich.ru](https://petrovich.ru/product/683559/) |
| 4 | Daxmer 10×90 пластиковый гвоздь, 30 шт | 199 ₽ | ✗ +22 ₽ | [petrovich.ru](https://petrovich.ru/product/1063074/) |
| 5 | Изоспан FL Termo 50×40 | 665 ₽ | ✗ +54 ₽ | [petrovich.ru](https://petrovich.ru/product/614336/) |
| 6 | ПН Knauf 28×27×3000 | 257 ₽/шт | ✗ +27 ₽/шт | [petrovich.ru](https://petrovich.ru/product/106483/) |
| 7 | ПН-2 Knauf 50×40×3000 | 434 ₽/шт | ✗ +46 ₽/шт | [petrovich.ru](https://petrovich.ru/product/106209/) |
| 8 | Листового «кирпича» нет; ближе: ПВХ 960×485×6 «офсет дымчатый» (толще вдвое) | 211 ₽/шт | условный | [petrovich.ru](https://petrovich.ru/product/1225746/) |
| 9 | ЦКИ нет; клопы Hard-Fix 4,2×25, 250 шт | 619 ₽ | ✗ +114 ₽ | [petrovich.ru](https://petrovich.ru/product/977093/) |
| 10 | Плинтус Идеал Классик 55 мм белый, кабель-канал | **125 ₽** ✓ | ✓ −43 ₽/шт | [petrovich.ru](https://petrovich.ru/product/1165198/) |
| 11 | ~~Venta 250×3000~~ — откосы переведены на МДФ «Брисбен» (полосы 140 мм, +4 панели к #8); углы — внахлёст-ступенькой без уголков | — | — | ✓ −2 254 ₽ к корзине |
| 12 | ~~F-профиль~~ — убран 08.10: примыкание откосов к раме — белый акриловый герметик | ~300 ₽ | узел без пластика | — |
| 13 | ВВГнг(А)-LS 3×2,5 в выдаче не найден (3×1,5 — 108 ₽/м против 80) | — | ✗ кабель оставить на Электролайте | — |
| 15 | Выключатель Valena 1 кл. **слоновая кость** (белого в топе нет) | 391 ₽ ✓ | ✓ −99 ₽, но цвет | [petrovich.ru](https://petrovich.ru/product/104765/) |
| 16 | GM-119 нет; Rexant R70XT 646 ₽ / R100B 4 151 ₽ — не под пост Valena | — | ✗ не аналог | [petrovich.ru](https://petrovich.ru/product/1056717/) |
| 17 | Розетка Valena с заземлением, слоновая кость (695612) | **341 ₽** ✓ | ✓ −99 ₽/шт, но цвет | [petrovich.ru](https://petrovich.ru/product/104780/) |
| 18 | Рамка Valena 5 постов нет (3-местная 362 ₽; Inspiria — другая серия) | — | ✗ | — |
| 19 | Коробка Systeme Electric IMT351001 d68×45 для бетона | 20 ₽/шт | ~ равно (19→20) ✓ | [petrovich.ru](https://petrovich.ru/product/128015/) |
| 20 | Подоконник ПВХ 200×2000×20 белый матовый (резать из 2 м) | 620 ₽ | ✗ +187 ₽ | [petrovich.ru](https://petrovich.ru/product/667619/) |
| 21 | Пена Tytan Professional Gun 750 всесезонная / Soudal Prof 60 летняя | 578 / 638 ₽ | цена для сметы (2 шт ≈ 1 156–1 276 ₽) | [petrovich.ru](https://petrovich.ru/product/1081662/) |

Выгода по стенам: F-профиль −4 600, Venta −268, плинтус −129, брусок 30×40 с Лемана −900 к Петровичу. **Обновление 08.10 (после таблицы): направляющие всех стен заменены на брусок 30×40 (Лемана ПРО, 193 ₽/шт; Петрович 30×45 — 268 ₽, дороже)** — профили ПН/ППН из заказа убраны; блок #15–19 — накладной (Makel + Grand Meyer MST-1).

### 7.3. Пол — корзина

| # | Материал | Кол-во | Цена, ₽ | Сумма, ₽ | Ссылка |
|---|---|---|---|---|---|
| 1 | PIR Logicpir Баня ф/ф Г1 L-кромка 1190×590×50 (пол 2,7 м², слой 1 — из общего заказа tstn) | 1 уп | 4 329 | 4 329 | [tver.tstn.ru](https://tver.tstn.ru/product/logicpir-banya-f-f-g2-l-1190kh590kh50/) |
| 2 | PIR Logicpir Баня ф/ф Г1 L-кромка 1190×590×30 (пол, слой 2, ~4 плиты; уп. задней стены впритык — заказ +1 уп) | 1 уп | 4 918 | 4 918 | [tver.tstn.ru](https://tver.tstn.ru/product/logicpir-banya-f-f-g2-l-1190kh590kh30/) |
| 3 | Суперпол Knauf 600×1200×20 мм, фальц ([624963](https://tver.petrovich.ru/product/624963/), 569 ₽ — пол 2,65 м²: 4 элемента в дело + кусок на ступень; ссылка 108042 устарела — отсутствует) | 5 | 569 | 2 845 | [tver.petrovich.ru](https://tver.petrovich.ru/product/624963/) |
| 4 | Клей-пена Технониколь Logicpir 1000 мл (2 слоя PIR + ступень; остатки потолка/стен прикроют часть) — tstn | 2 | 1 414 | 2 828 | [tver.tstn.ru](https://tver.tstn.ru/product/kley-pena-tekhnonikol-logicpir-1000-ml/) |
| 5 | Керамзит фр. 5–10 мм, 0,05 м³/мешок ([169324](https://tver.petrovich.ru/product/169324/)) — сухая засыпка ~37 мм: 2,66 м² ≈ 0,1 м³ + запас на неровности плиты | 3 | 339 | 1 017 | [tver.petrovich.ru](https://tver.petrovich.ru/product/169324/) |
| 6 | Лента демпферная кромочная КМ 8×100 мм 20 м ([997079](https://tver.petrovich.ru/product/997079/)) — периметр ~7,3 м, толщина 8 мм = зазор пирога от стен | 1 | 266 | 266 | [tver.petrovich.ru](https://tver.petrovich.ru/product/997079/) |
| 7 | ИК-плёнка Rexant 2,5 м² 550 Вт (220 Вт/м²), комплект | 1 | 5 279 | 5 279 | [lemanapro.ru](https://lemanapro.ru/product/infrakrasnaya-plenka-dlya-teplogo-pola-rexant-25-m-550-vt-90553937/) |
| 8 | Подложка Texfloor EVA с фольгой 3 мм, рулон 6,6 м² | 1 | 2 145 | 2 145 | [lemanapro.ru](https://lemanapro.ru/product/podlozhka-texfloor-eva-3-mm-s-folgirovannym-sloem-66m2-rulon-93044098/) |
| 9 | Плёнка техническая армированная 200 мкм, 2×10 м (техслой над ИК) | 1 | 947 | 947 | [lemanapro.ru](https://lemanapro.ru/product/plenka-tehnicheskaya-armirovannaya-200-mkm-2x10-m-86272872/) |
| 10 | SPC **Corsa Deco Laguna B300** 1218×180×5,3 мм, замковая, фаска, подложка IXPE, 2,631 м²/уп. ([petrovich.ru](https://petrovich.ru/product/1133918/)) — пол 2,65 м² + подрезка | 2 уп. | 3 947 | 7 894 |
| | **Итого, пол** | | | **32 468** | |

Терморегулятор Grand Meyer GM-119 — в смете стен, вторым постом рамки Valena. Датчик пола в гофре из остатка Элпласт, под плёнку. Скотч алюминиевый на швы пола — из остатков. Плинтус — в смете стен.

##### Аналоги на petrovich.ru — Пол (СПб, 08.10.2026)

| # | Аналог | Цена | К смете | Ссылка |
|---|---|---|---|---|
| 1 | PIR 50 — Logicpir Баня 50×590×1190 | 909 ₽/шт | ✗ дороже (671→909) | [petrovich.ru](https://petrovich.ru/product/1214673/) |
| 2 | Суперпол Knauf 1200×600×20: [624963](https://tver.petrovich.ru/product/624963/) | 569 ₽/лист | ✓ заказан здесь (108042 отсутствует; +19 ₽ к Лемане) | [tver.petrovich.ru](https://tver.petrovich.ru/product/624963/) |
| 3 | Logicpir нет; ТН 500 Professional 600 мл | 653 ₽ | ✗ | [petrovich.ru](https://petrovich.ru/product/683559/) |
| 4 | Caleo Silver 2 м² 150 Вт/м² (300 Вт) — мощность ниже, ₽/м² выше | 5 244 ₽ | ✗ (2 622 против 2 112 ₽/м²) | [petrovich.ru](https://petrovich.ru/product/674986/) |
| 5 | Подложка Isolon EcoHeat 3 мм металлизированная 1×8 м (8 м²) | **198 ₽** ✓ | ✓ −1 947 ₽ (2 145→198) | [petrovich.ru](https://petrovich.ru/product/969093/) |
| 6 | Плёнка армированная КМ 200 г/м² — 107,70 ₽/м², рулон 50 м² | ~5 385 ₽/рул | ✗ дороже и только большим рулоном (947 ₽/20 м² на Лемане) | [petrovich.ru](https://petrovich.ru/product/669598/) |
| 7 | ~~CronaFloor 1 460~~ → **выбрано 08.10: Corsa Deco Laguna B300** 5,3 мм с фаской и IXPE, 1 500 ₽/м² ([1133918](https://petrovich.ru/product/1133918/)): 2 уп = 7 894 ₽ | 3 947 ₽/уп | ✗ дороже (+4 974 ₽ к CronaFloor) — выбор по дизайну | [petrovich.ru](https://petrovich.ru/product/1133918/) |

Выгода по полу: подложка −1 947; ГВЛВ и ИК-плёнка дороже. SPC: изначальный «Дуб Берн» (−1 034) сменён на Corsa Deco (+3 008 к корзине) — решение по дизайну.

### 7.4. ФИНАЛЬНАЯ КОРЗИНА (08.10.2026, без альтернатив)

**Лемана ПРО — 13 593 ₽** (PIR и клей-пена перенесены 13.10 в фирменный магазин ТН: пена −25%, PIR на Лемане Тверь закончился)

| # | Позиция | Кол-во | Цена, ₽ | Сумма, ₽ |
|---|---|---|---|---|
| 4 | Монтажная пена проф. 750 мл (Tytan Gun класс) — цену сверить в корзине | 2 | ~578 | 1 156 |
| 5 | Термодюбель Sormat 8×155, уп. 30 (12 потолок + 18 стены) | 1 | 658 | 658 |
| 6 | Брусок строганый 30×40×3000, хвоя, Оптима (каркас всех стен) | 12 | 193 | 2 316 |
| 7 | ИК-плёнка Rexant 2,5 м² 550 Вт (220 Вт/м²) | 1 | 5 279 | 5 279 |
| 8 | Плёнка армированная 200 мкм 2×10 м | 1 | 947 | 947 |
| 9 | Бур SDS-plus 10×160 | 2 | 114 | 228 |
| 10 | Бур SDS-plus Rage Quadro-X 25×600 (ввод сквозь стену) — **куплен**, не заказывается | 1 | — | — |
| 11 | Набор коронок по дереву Matrix 64–127 (Ø90 под GX53) | 1 | 561 | 561 |
| 12 | Нивелир лазерный Ermenrich LT20 | 1 | 1 890 | 1 890 |
| 13 | Зубило лопаточное SDS-plus 40×250 — **куплено**, не заказывается | 1 | — | — |
| 14 | Чашка алмазная двухрядная по бетону Vira 592035 125×22,2 (шлифовка плиты пола) | 1 | 558 | 558 |

**ТЕХНОНИКОЛЬ Тверь — фирменный магазин (tstn.ru) — 39 965 ₽** (PIR — Г1, L-кромка; клей-пена на 25% дешевле Леманы)

| # | Позиция | Кол-во | Цена, ₽ | Сумма, ₽ |
|---|---|---|---|---|
| 1 | PIR Logicpir Баня Ф/Ф Г1 L-кромка 1190×590×50, уп. 5 плит/3,51 м² ([tver.tstn.ru](https://tver.tstn.ru/product/logicpir-banya-f-f-g2-l-1190kh590kh50/)) — потолок + стены + пол — **4 уп куплено 15.10**, докупить 1 уп по факту расхода (расчёт потолок 3,0 + стены боковые 6,0 + пол 2,65 ≈ 11,7 м²) | 5 уп | 4 329 | 21 645 |
| 2 | PIR Logicpir Баня Ф/Ф Г1 L-кромка 1190×590×30, уп. 8 плит/5,62 м² ([tver.tstn.ru](https://tver.tstn.ru/product/logicpir-banya-f-f-g2-l-1190kh590kh30/)) — задняя стена | 1 уп | 4 918 | 4 918 |
| 3 | PIR Logicpir Баня Ф/Ф Г1 L-кромка 1190×590×30, уп. 8 плит/5,62 м² — **пол, слой 2** (нужно ~4 плиты; уп. задней стены впритык, без остатка) | 1 уп | 4 918 | 4 918 |
| 4 | Клей-пена ТЕХНОНИКОЛЬ LOGICPIR 1000 мл ([tver.tstn.ru](https://tver.tstn.ru/product/kley-pena-tekhnonikol-logicpir-1000-ml/)) — приклейка плит + выравнивающие полосы пола (2+2+2) — **2 куплено 15.10**, докупить 4 | 6 | 1 414 | 8 484 |

**Электролайт — 1 532 ₽**

| # | Позиция | Кол-во | Цена, ₽ | Сумма, ₽ |
|---|---|---|---|---|
| 1 | Кабель ВВГ-Пнг(А) 3×1,5 ГОСТ, Дмитровкабель (свет; расчёт 7,6 м) — **куплен**, не заказывается | — | — | — |
| 2 | Кабель ВВГ-Пнг(А) 3×2,5 ГОСТ, Дмитровкабель (ввод+розетки+пол; расчёт 12,1 м) — **куплен**, не заказывается | — | — | — |
| 3 | Гофра ПВХ D16 нг с зондом (свет + датчик) — **куплена**, не заказывается | — | — | — |
| 4 | Клемма WAGO 2273-203 на 3 провода | 6 | 66 | 396 |
| 5 | Лампа GX53 10 Вт 4000К Smartbuy | 3 | 90 | 270 |
| 6 | Коробка распаячная EKF 80×50×80 IP54 | 1 | 96 | 96 |
| 7 | Терморегулятор Grand Meyer MST-1 накладной (датчик пола) | 1 | 770 | 770 |

**Петрович — 39 012 ₽ к заказу** (купленное исключено: подвесы 13.10, пистолет №1 13.10, круги/изолента/ножи/правило 15.10)

| # | Позиция | Кол-во | Цена, ₽ | Сумма, ₽ |
|---|---|---|---|---|
| 2 | Дюбель Daxmer 10×90, 30 шт (PIR стен) | 1 уп. | 199 | 199 |
| 3 | Подвес прямой Knauf 60×27, 30×302 мм, 0,9 мм ([tver.petrovich.ru](https://tver.petrovich.ru/product/106238/)) — **12 шт куплено 13.10**, не заказывается | 12 | — | — |
| 4 | Саморезы Hard-Fix 4,2×25 усиленные, 250 шт (клопы + панели) | 1 уп. | 619 | 619 |
| 5 | Панель ПВХ Venta 375×3000×8 глянцевая белая (потолок: 8 полос × 1077) | 5 | 575 | 2 875 |
| 6 | Светильник Navigator ДВО GX53 IP20 | 3 | 125 | 375 |
| 7 | Антисептик-огнебиозащита для бруска, ~1,5 л | 1 | ~350 | 350 |
| 8 | Розетка тройная Legrand Quteo 782238 накладная с/з белая | 1 | 471 | 471 |
| 9 | Выключатель Legrand Quteo 782201 накладной 1 кл. (цену сверить при заказе) | 1 | ~150 | 150 |
| 10 | Панель МДФ Stella «ледяное дерево» 2700×200×6 (стены ~22 + откосы 4) | 26 | 520 | 13 520 |
| 11 | Плинтус Идеал Классик 55 мм белый | 3 | 125 | 375 |
| 12 | Герметик акриловый Soudal «Моментальный» белый 280 мл | 1 | 442 | 442 |
| 13 | Подоконник ПВХ 200×2000×20 белый матовый | 1 | 620 | 620 |
| 14 | Суперпол Knauf 1200×600×20 ([624963](https://tver.petrovich.ru/product/624963/); 108042 отсутствует) — 4 элемента в дело + кусок на ступень | 5 | 569 | 2 845 |
| 15 | Подложка Isolon EcoHeat 3 мм металлизированная 1×8 м | 1 | 198 | 198 |
| 16 | SPC Corsa Deco Laguna B300 1218×180×5,3, фаска, подложка IXPE | 2 уп. | 3 947 | 7 894 |
| 17 | Пистолет для пены Сибртех 88678 (пена + клей-пена раздельно) — **№1 куплен 13.10**, №2 к заказу | 1 | 599 | 599 |
| 18 | Бур SDS-plus Практика Профи 8×210 | 2 | 199 | 398 |
| 19 | Круг отрезной Луга 125×22,2×1,2 — **куплен 15.10** (вместе с изолентой и ножами), не заказывается | 3 | — | — |
| 20 | Пика SDS-plus КМ 250 — **куплена**, не заказывается | 1 | — | — |
| 21 | Уголок МДФ Stella складной «ледяное дерево» 24×24×2700 | 7 | 248 | 1 736 |
| 22 | Жидкие гвозди для уголков | 1 | ~300 | 300 |
| 23 | Правило алюминиевое 2,5 м трапеция Hesler — **куплено 15.10**, не заказывается | 1 | — | — |
| 24 | Керамзит фр. 5–10 мм 0,05 м³ ([169324](https://tver.petrovich.ru/product/169324/)) — сухая засыпка ~37 мм по PIR | 3 | 339 | 1 017 |
| 25 | Лента демпферная кромочная КМ 8×100 мм 20 м ([997079](https://tver.petrovich.ru/product/997079/)) — периметр сухой стяжки | 1 | 266 | 266 |
| 26 | Стол малярный Ринстрой 2,78 м складной ([129874](https://tver.petrovich.ru/product/129874/)) — помост для потолка (PIR, профиль, панели, светильники; рабочая высота 2,78 м, настил 0,76 м) + стол для раскроя | 1 | 3 763 | 3 763 |

**ВсеИнструменты — 4 666 ₽** (один заказ: уровень + правило + скотч)

| # | Позиция | Кол-во | Цена, ₽ | Сумма, ₽ |
|---|---|---|---|---|
| 1 | Уровень магнитный усиленный Зубр «Профессионал-М» 1000 мм с зеркальным глазком (34589-100_z01) | 1 | 2 257 | 2 257 |
| 2 | Правило алюминиевое трапеция с рёбрами жёсткости СИБРТЕХ 89602, 1,5 м ([vseinstrumenti.ru](https://www.vseinstrumenti.ru/product/alyuminievoe-trapetsievidnoe-pravilo-s-rebrami-zhestkosti-1-5-m-sibrteh-89602-543315/)) | 1 | 929 | 929 |
| 3 | Лента алюминиевая Unibob 50 мм × 40 м ([vseinstrumenti.ru](https://www.vseinstrumenti.ru/product/alyuminievaya-klejkaya-lenta-unibob-50-mm-h-40-m-134860-1103742/)) — пароизоляция швов/шляпок/периметра | 2 | 740 | 1 480 |

**ИТОГО ФИНАЛЬНОЙ КОРЗИНЫ (к заказу, купленное исключено): 13 593 + 39 965 + 1 532 + 39 012 + 4 666 = 98 768 ₽**

В наличии (не заказывается): профиль CD 60×27 — 4 шт., алмазный диск по бетону (куплен 07.10), пика и зубило SDS-plus, бур Rage 25×600, кабели ВВГ 3×1,5 и 3×2,5, гофры ПВХ D16 и D20, пылесос — куплено.
Проверить при получении/заказе: диаметр выреза светильников Navigator (~90 мм), посадка панели 10 мм в F-профиль с полкой 25 мм, фактические цены Quteo-выключателя, пены, антисептика, жидких гвоздей.
В комнаты: подрозетник Ø68 в комнате на оси ввода (80 мм от угла, ~2,23 м от пола) + 3 клеммы WAGO 221 на PE/L/N — докупить при монтаже.

## 8. Альтернативы

### 8.1. Потолок

- Профиль дешевле: [Standers ПП 0,55 мм 60×27×3000](https://lemanapro.ru/product/profil-potolochnyy-standers-055-mm-60x27x3000-mm-18304547/) — 243 ₽/шт
- Подвес дешевле: [Премиум 60×27 мм L295 мм 0,9×120 мм](https://lemanapro.ru/product/podves-pryamoy-60x27-mm-l295-mm-09x120-mm-premium-14394434/) — 8,90 ₽/шт; [Standers](https://lemanapro.ru/product/pryamoy-podves-dlya-pp-60x27-standers-81931801/) — 11,30 ₽/шт. [Евростандарт 0,5 мм за 6 ₽](https://lemanapro.ru/product/podves-pryamoy-60x27-mm-l300-mm-05-mm-evrostandart-12902562/) — не советую: тонкая полоса плохо держит ровный отгиб
- Подвес длиннее (если плита с наплывами): [Knauf 200 мм](https://lemanapro.ru/product/podves-pryamoy-knauf-200-mm-dlya-potolochnogo-profilya-60x27-mm-82632744/) — 25 ₽/шт
- Клопы упаковкой (если «на вес» неудобно): [полуцилиндрические острые фосфатированные 3,5×9,5, 400 шт.](https://lemanapro.ru/product/samorezy-po-metallu-polucilindricheskie-ostrye-fosfatirovannye-35x95-400-sht-89026071/) — 358 ₽. Со сверлом не нужны — оцинковка 0,6 мм прокалывается острым
- Та же фольга с L-кромкой, по теплу без разницы (λᴅ 0,023): [Premium Logicpir Балкон Ф/Ф 1190×590×50, 5 шт (3,51 м²)](https://lemanapro.ru/product/teploizolyacionnaya-pir-plita-tehnonikol-premium-logicpir-balkon-f-f-l-kromka-1190x590x50mm-5sht-351m-91014558/) — 7 800 ₽. Прямой край поштучного листа закрывается пеной и алюминиевым скотчем
- Клей-пена дешевле: [Penoplex Fastfix 750 мл](https://lemanapro.ru/product/kley-pena-penoplex-fastfix-750-ml-82117429/) — 653 ₽
- Термодюбель с запасом по длине: [Tid 8×175, 30 шт.](https://lemanapro.ru/product/dyubel-dlya-teploizolyacii-tid-gvozd-s-termogolovkoy-8x175-mm-30-sht-89383422/) — 518 ₽ — нет в наличии; [Tid 8×155](https://lemanapro.ru/product/dyubel-dlya-teploizolyacii-tid-gvozd-s-termogolovkoy-8x155-mm-30-sht-89383421/) — 498 ₽
- Цельнопластиковый грибок без мостика холода: [10×180, 30 шт.](https://lemanapro.ru/product/dyubel-dlya-teploizolyacii-10x180-mm-30-sht-84038992/) — 543 ₽, пластиковый гвоздь, в бетоне ~75 мм
- Запасной вариант: [IZO 10×160, 30 шт.](https://lemanapro.ru/product/dyubel-dlya-teploizolyacii-izo-10x160-mm-30-sht-84039080/) + [гвоздь IZM 10×160, 30 шт.](https://lemanapro.ru/product/dyubel-dlya-teploizolyacii-izm-gvozd-stal-10x160-mm-30-sht-84038991/) — классическая пара, в бетоне ~60 мм, но без термоголовки у гвоздя
- Более короткие грибки (10×120, 10×140) под пирог 100 мм не подходят — в бетоне остаётся 20–40 мм
- Скотч дешевле: [Клейкая лента алюминиевая «Изобонд»](https://lemanapro.ru/product/kleykaya-lenta-alyuminievaya-izobond-82333112/) — 441 ₽
- Панель пошире (меньше стыков): [Venta Белый глянец 3000×250×10](https://lemanapro.ru/product/panel-pvh-venta-belyy-glyancevyy-3000x250x10-mm-075-m-89423853/) — 520 ₽/шт (нужно 6), гладкая жёсткая, но рейтинг 4,3 всего по 4 оценкам
- Панель потолочная рельефная: [2-х секционная фигурная 3000×200×8 мм](https://lemanapro.ru/product/potolochnaya-panel-2-h-sekcionnaya-figurnaya-3000x200x8-mm-06-m-82540423/) — 461 ₽/шт, 4,3/5 (54 оценки), но рельеф — рамки GX53 встанут с зазорами
- Панели 5 мм (Белый глянец/матовый 3000×250×5, Artens 2700×375×5) — **не брать**: рейтинг 2,9–3,7, массовые жалобы на хрупкость
- Светильник дешевле: [точечный под отверстие 90 мм GX53, белый](https://lemanapro.ru/product/svetilnik-tochechnyy-vstraivaemyy-pod-otverstie-90-mm-gx53-cvet-belyy-89413689/) — 78 ₽/шт или [Ecola GX53, 4 шт.](https://lemanapro.ru/product/komplekt-tochechnyh-svetilnikov-vstraivaemyh-ecola-5357-pod-otverstie-95-mm-gx53-cvet-chernyy-4-sht-93903038/) — 515 ₽ за 4 шт.
- Лампа: [Volpe GX53 12 Вт](https://lemanapro.ru/product/lampa-svetodiodnaya-volpe-gx53-220-240-v-12-vt-spot-matovaya-1100-lm-neytralnyy-belyy-svet-89830452/) — 145 ₽ — **не рекомендую**: рейтинг 3,6/5 (158 оценок), в отзывах греется выше 80 °C и мерцает. [Gauss 10,5 Вт](https://lemanapro.ru/product/lampa-svetodiodnaya-gauss-gx53-170-240-v-105-vt-krug-matovaya-900-lm-holodnyy-belyy-svet-88279490/) — 288 ₽, 4,3/5 (48 оценок), но свет холодный 6500К
- Кабель без пометки ГОСТ на Электролайте дешевле: [ВВГнг 3×1,5 плоский чёрный, 55 ₽/м](https://electrolait.ru/shop/kabel/vvg/vvgng-3h15-ploskij-chernyj/) — в корзину не берём

### 8.2. Стены

- Кирпич белый вместо серого: [Lako decor Классический кирпич белый 770×700×5, 5 шт](https://lemanapro.ru/product/komplekt-paneley-pvh-lako-decor-klassicheskiy-kirpich-belyy-770x700x5mm-27m-5sht-91967289/) — 999 ₽/2,7 м² (370 ₽/м²), рейтинг 4,5 по 4 оценкам; лист 5 мм толще, пирог +2 мм
- Кирпич бежевый дешевле всех: [Lako 550×500, 10 шт, 2,75 м²](https://lemanapro.ru/product/komplekt-paneley-pvh-lako-decor-klassicheskiy-kirpich-bezhevyy-550x500mm-275m-10sht-91460330/) — 499 ₽ (182 ₽/м²), 8 отзывов
- ПВХ лист «Бремен» под камень: [960×485×3](https://lemanapro.ru/product/listovaya-panel-pvh-960x485x3-mm-bremen-047-m-84793080/) — 213 ₽, 84 отзыва
- PIR стен дешевле нет: Logicpir поштучно (931 ₽/м²) уже вдвое-втрое дешевле упаковок «Балкон Premium» и Logicpir Баня
- Регулятор пола на Электролайте в чужую рамку не садится: GM-119 только под Valena. Отдельный встраиваемый без общей рамки — [Grand Meyer MST-1, 770 ₽](https://electrolait.ru/shop/teplyj-pol/termoregulyatory/termoregulyator-mst-1-grand-meyer-belyj-gollandiya/)

### 8.3. Пол

- ИК-плёнка мягче и дешевле: [Rexant 2,5 м² 375 Вт (150 Вт/м²) — 4 872 ₽](https://lemanapro.ru/product/infrakrasnaya-plenka-dlya-teplogo-pola-rexant-25-m-375-vt-90553953/) — для утеплённой лоджии хватает, прогрев медленнее
- SPC дешевле: [«Дуб Санкт-Петербург» 42 класс 4 мм — 165 отзывов](https://lemanapro.ru/product/spc-plitka-dub-sankt-peterburg-klass-42-tolshchina-4-mm-216-m-89396939/); с интегрированной подложкой (лишний слой над ИК, не рекомендуется): [Intenso 5 мм — 210 отзывов](https://lemanapro.ru/product/spc-plitka-intenso-s-podlozhkoy-43-klass-tolshchina-5-mm-2631-m-88010970/)
- ГВЛВ дешевле за м², но с прямой кромкой: [Суперлист 1200×2500×12,5 — 1 078 ₽/лист](https://lemanapro.ru/product/gipsovoloknistyy-list-gvlv-pk-125-mm-knauf-superlist-1200x2500-mm-13303190/); фальцевые элементы Суперпол предпочтительны — стыки без ступенек

### 8.4. Инструменты

- Пистолет надёжнее: [Tris, 1 350 ₽](https://lemanapro.ru/product/professionalnyy-pistolet-dlya-montazhnoy-peny-tris-82391627/)
- Лазер с зелёным лучом — лучше виден, но на фольге всё равно нужен экран: [Elitech 16Л-ЗЕЛ, 3 878 ₽](https://lemanapro.ru/product/nivelir-lazernyy-elitech-16l-zel-zelenyy-luch-89367685/)
- Диски: [1,6 мм — 23 ₽](https://lemanapro.ru/product/disk-otreznoy-po-metallu-sibrteh-743157-125x222x16-mm-88022835/), [2,0 мм — 36 ₽](https://lemanapro.ru/product/disk-otreznoy-po-metallu-sibrteh-743167-125x222x2-mm-88022836/) — под тонкий профиль не нужны, 1,2 мм ровнее и не жжёт край

## 9. Открытые вопросы (решить до заказа/монтажа)

- **Простенок слева от окна (X 0–125)**: вариант — не обшивать листом «Кирпич серый», а довести откос Venta от рамы до панели левой стены (единый белый узел, без узкой подрезки). Цена +289 ₽ (кирпич −1 лист, Venta +1 панель, периметр откосов 9,1 → 11,9 м); обязательное условие — канавка 16 мм в PIR под гофру ввода на подъёме 260 мм. Сейчас в проекте — лист на клей-пене без стойки. Решение — до заказа панелей.

Лобзик из списка убран: пластик (ламели 10 мм, Venta, листы 3 мм) режется строительным ножом по правилу в несколько проходов; PIR — ножом. Отверстие под светильник — коронкой 89 мм, доводка ножом.
