AndreyPlis/balcon/init.md

Левая стена
Ширина
Низ 1.075  верх 1.65
Высота
Слева 2.798 справа 2.806

Права стена
Ширина
Низ 1.081 верх 1.072
Высота справа 2.802 слева 2.811

Пол ширина
Низ сторона к входу 2.793 сторона к окну 2.789

Потолок ширина
Сторона к входу 2.784 сторона к окну 2.788

Окна
Доборы до штапика
Правый бок низ 12.5 верх 12.5

Верх 12 низ 18

Лево низ 12.5 -13 середина 14 верх 13.5

Стена справа от проема
Низ 1.209 верх 1.213

Над проемом 0.307

Слева от проема окна  до стены 12.5

Под окном высота  от пола 0.920 - 0.915

Ширина  подоконник 73.5

Ширина до левой стены 0.863

Высота двери проема от пола  23.5
Плюс 5 см до пластика двери

Сам проем
Дверь ширина 0.703 высота 2.257
Окно высота 1.570
Ширина совместная с дверью  1.435- 1.440

Подоконник глубина 13 плюс 1 см углубление

Ступенька глубина 15 ширина 70.5

Справа глубина двери 14
