AndreyPlis/balcon/render_day_corner.png

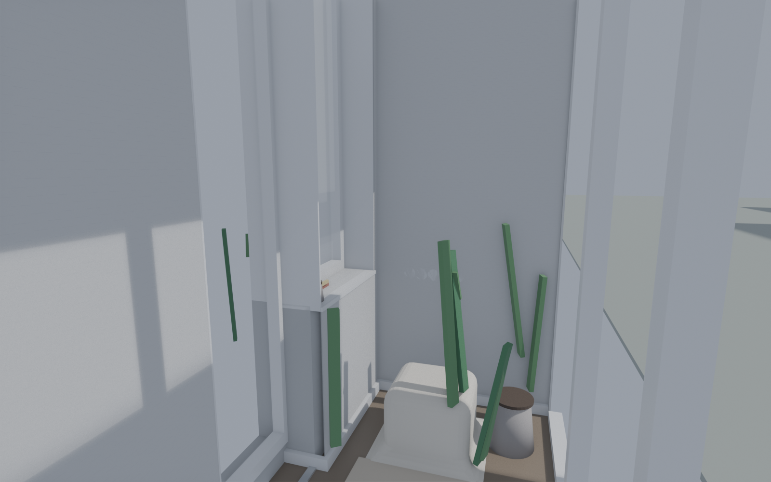
render_day_corner.png
