AndreyPlis/balcon/render_day_door.png

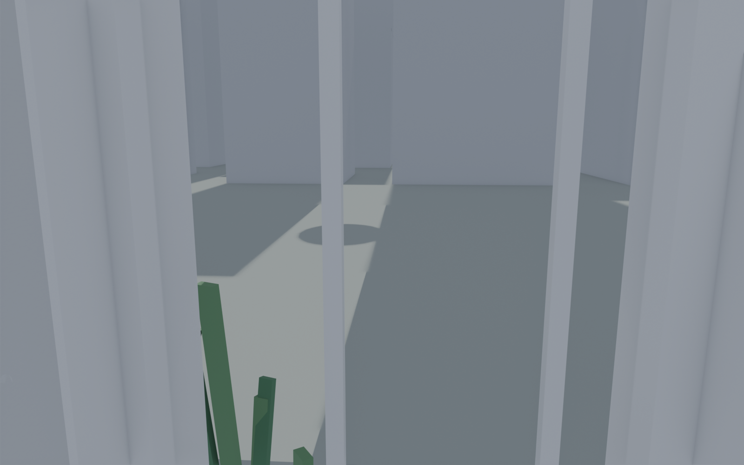
render_day_door.png
