AndreyPlis/balcon/materials.md

https://www.youtube.com/watch?v=9BPyGYhEAY8

https://www.youtube.com/watch?v=_zJsMWyXZt4

https://www.youtube.com/watch?v=zC0hL7GAGbw

новое 

https://www.youtube.com/watch?v=MEhm3lcVnyE
