AndreyPlis/balcon/Loggia.FCStd

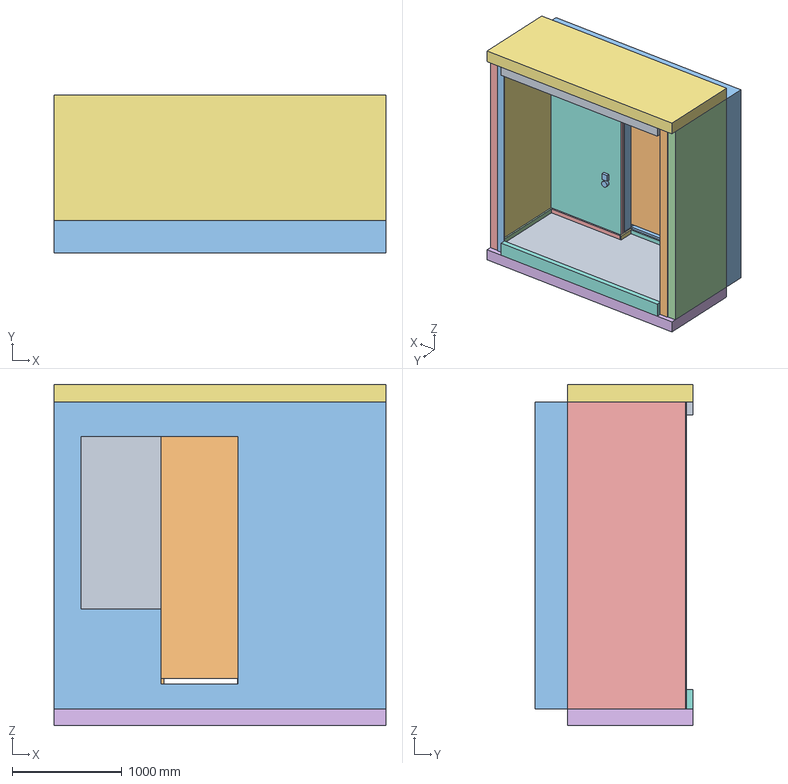
[picture p5: CAD file, 2026-10-31]
Loggia.FCStd
3031.0 x 1447.0 x 3116.0 mm
BackWindowGlass
BackDoorLeaf
DoorReveal_R
WallLeft_Brick
WallRight_Brick
SlabFloor
SlabCeil
FrontParapet
FrontTopBand
RevealPan_Left
RevealPan_Right
Подоконник старый (снимается)
Ступень (кирпич, срез до 120)
Гофра вводного 3×2,5: по фольге к коробке (Y)
Гофра вводного 3×2,5: по фольге к коробке (X)
Гофра D16: коробка → линия GX53
Гофра D16: линия GX53
Коробка распаячная 80x80 (WAGO)
Накл. выключатель света (задняя стена, на рейке, вертикально над Terneo)
Гофра 3×2,5 (розетки + пол): по левой стене поверх PIR
Гофра 3×2,5 (розетки + пол): спуск к блоку
Свет 3x1,5: JBox -> задняя стена (потолок)
Свет: поворот в заднюю полость (пропил панели за потолком)
Гофра датчика пола: от Terneo вниз, далее по подложке
Гофра вводного 3×2,5: подъём по задней стене от ввода
Гофра 3×2,5 (розетки + пол): от коробки к левой стене
Датчик пола (маркер)
PIR Logicpir 30 ф/ф: простенок слева
PIR Logicpir 30 ф/ф: простенок справа
PIR Logicpir 30 ф/ф: над окном/дверью
PIR Logicpir 30 ф/ф: под окном
PIR Logicpir 50 ф/ф: левая стена
PIR Logicpir 50 ф/ф: правая стена
ППН 28×27: задняя стена, правый простенок #1
ППН 28×27: задняя стена, правый простенок #2
ППН 28×27: задняя стена, правый простенок #3
ППН 28×27: задняя стена, вставка над проёмом (стык листов)
ППН 28×27: задняя стена, вставка под окном #1
Панель Кирпич серый: правая
Панель Кирпич серый: простенок справа
Панель Кирпич серый: над проёмами
Панель Кирпич серый: под окном
Плинтус: левая стена
Плинтус: правая стена
Подоконник ПВХ 200 мм (новый)
ППН 50×40: левая стена #1
ППН 28×27: правая стена #1
ППН 50×40: левая стена #2
ППН 28×27: правая стена #2
ППН 50×40: левая стена #3
ППН 28×27: правая стена #3
Плинтус: задняя стена, слева от двери
Плинтус: задняя стена, справа от двери
Плинтус: грань проёма слева
Плинтус: грань проёма справа
Плинтус у рамы двери (закрывает шов SPC у коробки)
ППН 28×27: задняя стена, вставка над проёмом #2
ППН 28×27: задняя стена, вставка под окном #2
ППН 28×27: задняя стена, вставка над проёмом #3
PIR Logicpir 50 ф/ф, слой 1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
