AndreyPlis/balcon/(list of files, cad)

Other CAD files:
loggia_design.blend
